giaogiaooo/AED-Rescue-Vehicle-system/fall/train/val_batch2_pred.jpg

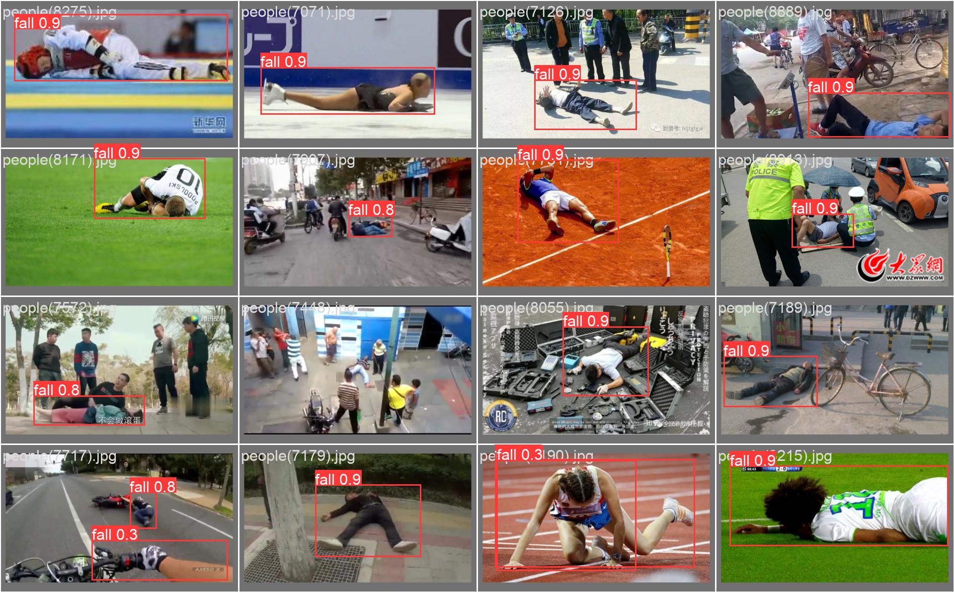
fall/train/val_batch2_pred.jpg
