giaogiaooo/AED-Rescue-Vehicle-system/fall/train/train_batch1.jpg

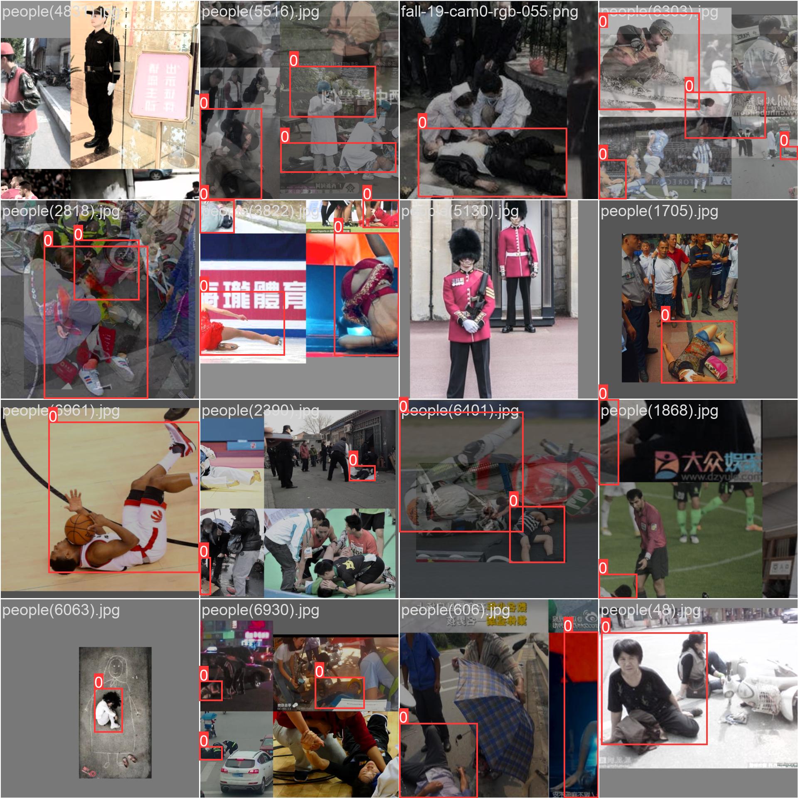
fall/train/train_batch1.jpg
