giaogiaooo/AED-Rescue-Vehicle-system/README.md

# AED Rescue Vehicle System

Intelligent AED (Automated External Defibrillator) rescue vehicle system — an integrated solution for rapid emergency cardiac arrest response.
