giaogiaooo/AED-Rescue-Vehicle-system/report/智能AED救援车系统.pdf

## 智能 AED 救援车系统

摘要

针对公共场所心脏骤停患者黄金救援时间短、传统人工取送自动体外除颤器

（AED）效率较低的问题，我们团队设计了基于 ROS2 的智能 AED 救援车系统。

该系统由主导航、目标检测、跌倒识别、语音交互、远程控制及自动返航等功能

于一体，能够在接收到救援任务后快速规划最优路径，自主避障并将 AED 运输

至目标位置，为现场急救争取宝贵时间。

本系统以 ELF2 开发板为核心，结合二维激光雷达，实现环境建模、定位导

航及障碍物检测；利用深度学习目标检测算法识别人体状态，对疑似跌倒人员进

行智能判断；在导航过程中，通过语音播报提醒周围人员避让，并引导现场人员

及时取用 AED 实施救援。到达目标点后，小车自动停止报警并等待救援完成，

在规定时间内可执行返航任务，提高设备利用率和连续工作能力。

实验结果表明，该 AED 救援小车能够在复杂室内环境中稳定完成自主导航、

动态避障、目标识别和 AED 配送任务，具有较高的导航精度、运行稳定性和实

时响应能力。该系统能够有效缩短 AED 送达时间，降低人工配送成本，为智慧

医疗、智慧校园、医院、商场及大型公共场所的应急救援提供了一种智能化、自

动化的解决方案，具有良好的应用价值和推广前景。

关键词：AED；智能救援小车；ROS2；自主导航；跌倒检测；激光雷达；目标

识别

第一部分作品概述

2.1 功能与特性

智能 AED 急救小车旨在解决公共场所突发心搏骤停时“黄金四分钟”

内的 AED 快速投递问题，化被动的“人找设备”为主动的“设备找人”。其

核心功能包括：

跌倒精确识别：通过 rknn 模型接入远程摄像头的视频，实现对患者跌倒

的快速识别，同时为了准确性，调高置信度，加入连续十帧触发机制，避免

误识别。

自主导航与动态避障：结合 Nav2 导航和 AMCL 定位，小车能在复杂、

人流密集的室内外环境中自主规划最优路径，并实现对行人及障碍物的实时

动态避让。

实时语音交互：设备内置扬声器，可实现语音播报和警报功能，汇报当

前执行情况，并在行程中鸣笛提醒周围行人注意避让。

本小车具备响应速度快、部署灵活、人机交互界面友好等特性，极大提

升了公共空间的急救效率。

2.2 应用领域

智能 AED 救援小车主要应用于面积广阔、人流密集且突发心血管疾病

风险较高的公共场所。具体包括：

大型交通枢纽：如地铁站（例如徐州地铁网内各站）、高铁站、机场航站

楼，解决站内面积庞大、人工寻找固定 AED 耗时过长的问题。

高校校园与体育场馆：针对学生进行高强度体测（如 3km 长跑或 400m

冲刺）、大型体育赛事及日常操场锻炼时突发心脏骤停事件，提供快速的赛道

旁医疗响应。

大型商超与展览中心：在内部结构复杂的商业环境中，小车能够穿梭于

人群和货架之间，精准将设备送达求救者手中。

智慧社区与工业园区：作为智慧安防与医疗基础设施的一部分，与园区

的监控系统联动，为老年人和工作者提供全天候的生命保障。

2.3 主要技术特点

本系统采用 ROS 机器人操作系统作为软件框架，实现模块化设计与多

节点协同运行。

（1）基于激光雷达 SLAM 技术完成环境建图与 AMCL 定位，实现高精

度自主导航；

（2）采用全局路径规划与局部避障算法，能够在复杂环境下安全运行；

（3）结合深度学习目标检测技术，实现跌倒人员识别与救援目标确认；

（4）支持远程监控与任务调度，可实时查看小车运行状态；

（5）具备自动返航与待机功能，提高设备利用率和系统可靠性；

（6）采用模块化硬件架构，便于后续功能扩展和维护升级。

2.4 主要性能指标

2.5 主要创新点

（1）将AED配送与自主移动机器人技术相结合，实现急救设备智能化配送。

（2）融合激光雷达导航与视觉跌倒检测技术，实现“发现—运输—送达”一

体化救援流程。

（3）设计智能语音引导机制，提高现场群众参与急救的效率。

（4）具备自动返航与循环工作能力，提升公共场所 AED 设备利用率。

（5）采用 ROS 模块化架构，便于后续功能扩展和智慧医疗系统接入。

指标项目 | 性能参数
导航方式 | 激光雷达自主导航
定位精度 | ≤10cm
最大运行速度 | 0.8~1.2m/s
避障距离 | ≥0.3m
跌倒检测准确率 | ≥90%
自动返航成功率 | ≥95%

2.6 设计流程

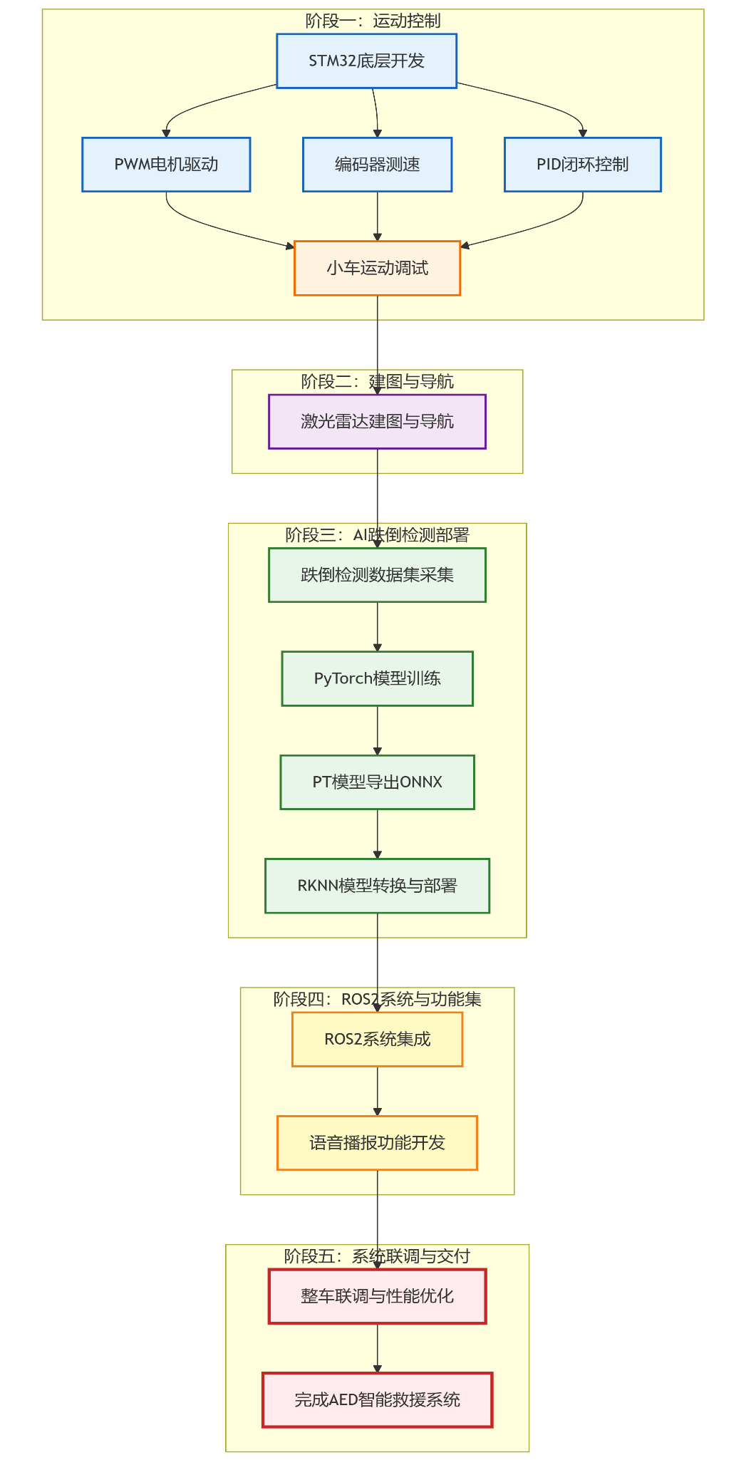
[picture p3: figure]

第二部分系统组成及功能说明

2.1 整体介绍

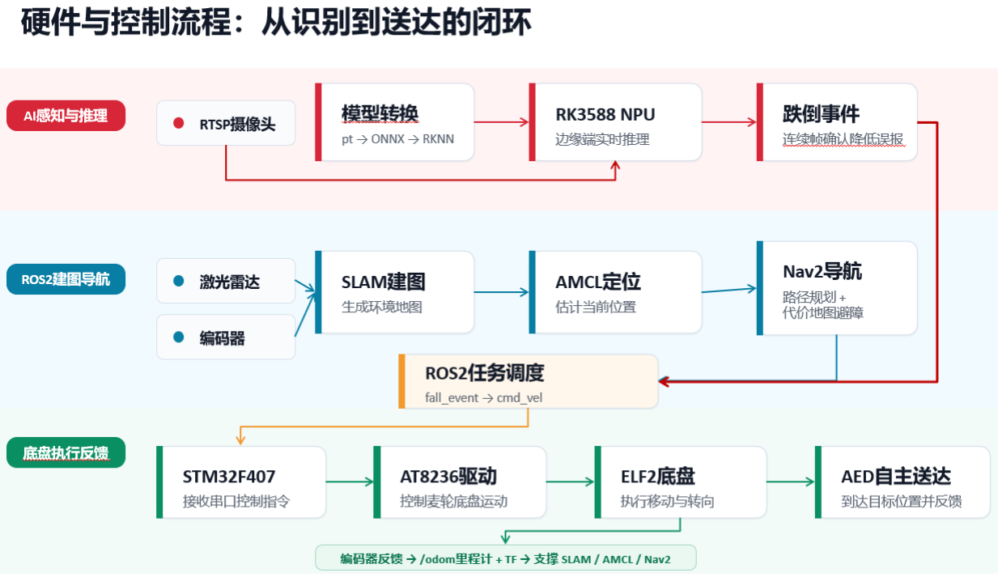
[picture p4: figure]

2.2 硬件系统介绍

2.2.1 硬件整体介绍

本系统采用"上位机智能决策+下位机运动控制"的分层硬件架构，由

ELF2 边缘计算平台、STM32 运动控制器、激光雷达、驱动模块、动力系统

及通信模块组成。

ELF2 作为系统上位机，负责运行 Ubuntu 操作系统及 ROS2 框架，完成

地图构建、自主导航、路径规划、跌倒检测模型推理、任务调度及语音播报

等高层功能。视觉算法采用 RKNN 部署于 ELF2 内置 NPU，实现跌倒检测模

型的边缘端实时推理。

STM32 作为底层运动控制核心，主要负责底盘运动控制及外设管理，包

括 PWM 输出、电机速度闭环控制、编码器数据采集、超声波测距及各类 IO

控制。STM32 根据 ELF2 发送的速度指令完成左右轮电机控制，并实时反馈

编码器信息，为自主导航提供稳定可靠的运动基础。

电机驱动部分采用 AT8236 双路直流电机驱动模块，可提供较大的输出

电流，支持 PWM 调速及电机正反转控制。STM32 输出 PWM 及方向控制信

号至 AT8236，驱动两台 520 减速直流电机完成差速运动，实现前进、后退、

转向及原地旋转等动作。

环境感知部分采用 LD06 二维激光雷达，实现周围环境扫描与障碍物检

测。LD06 通过串口与 ELF2 通信，配合 ROS2 完成 SLAM 建图、AMCL 定

位及 Nav2 自主导航，为车辆提供可靠的环境感知能力。

ELF2 与 STM32 之间采用 TTL 转 USB 通信模块进行串口数据交互。

STM32 通过 USART 发送底盘状态、编码器速度等信息，ELF2 接收导航算

法计算得到的速度控制指令，并将其发送至 STM32 执行，实现上下位机之

间稳定、高效的数据通信。

系统动力部分采用四台 520 减速直流电机作为驱动机构，配合编码器实

现闭环速度控制，提高车辆运动精度及导航稳定性。整车采用大容量锂电池

集中供电，并通过降压模块为激光雷达提供稳定电源，保证系统长时间稳定

运行。

2.2.2 机械设计介绍（如果有的话，从总体到局部，逐级给出各组件的具体设

计图，可以是 CAD 文件截图或者手绘图片）；

车壳采用 3D 打印的方式，分开打印车壳和 AED 底座、AED 模型，再

将三者组装到一起。其中，车壳上方预留了雷达的孔位，车后侧预留了和 AED

底座的螺丝连接口，侧面增加了散热口。AED 模型通过磁吸方式与 AED 底

座连接。摄像头外壳也采用了 3D 打印，起到一个保护且更加美观的效果。

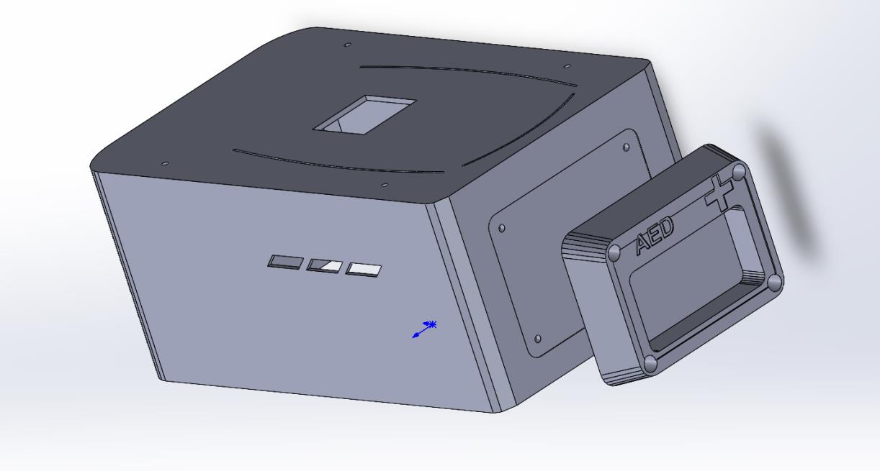
[picture p5: figure]

图 2.2.2.1 车体设计

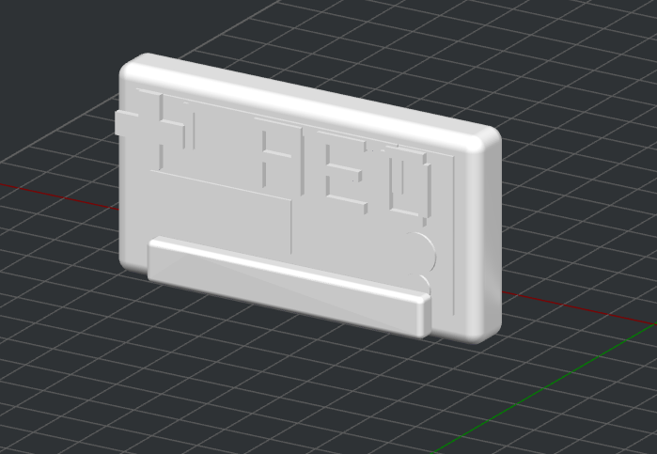
[picture p6: figure]

图 2.2.2.2AED 模型设计

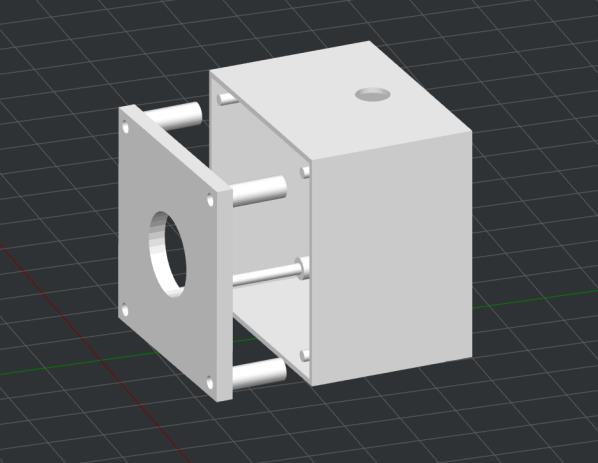
[picture p7: figure]

图 2.2.2.3 摄像头外壳设计

2.2.3 电路各模块介绍（从总体到局部，逐级给出各模块的具体设计图，并标

记出关键的输入、输出信号线，可以是电路图、SCH 原理图、PCB 版图等截图）；

1.总体连接关系

整车电路可以按“上位机计算、底层控制、感知供电、动力执行”四层理解。ELF2

负责接收 LD06 雷达数据并运行导航/上位机逻辑；STM32F407ZGT6 通过 TTL 转

USB 接收 ELF2 指令；AT8236 根据 STM32F407ZGT6 的 A/B 路控制信号驱动 520 马

达，同时将执行状态、故障或采样信息回传给 STM32F407ZGT6。

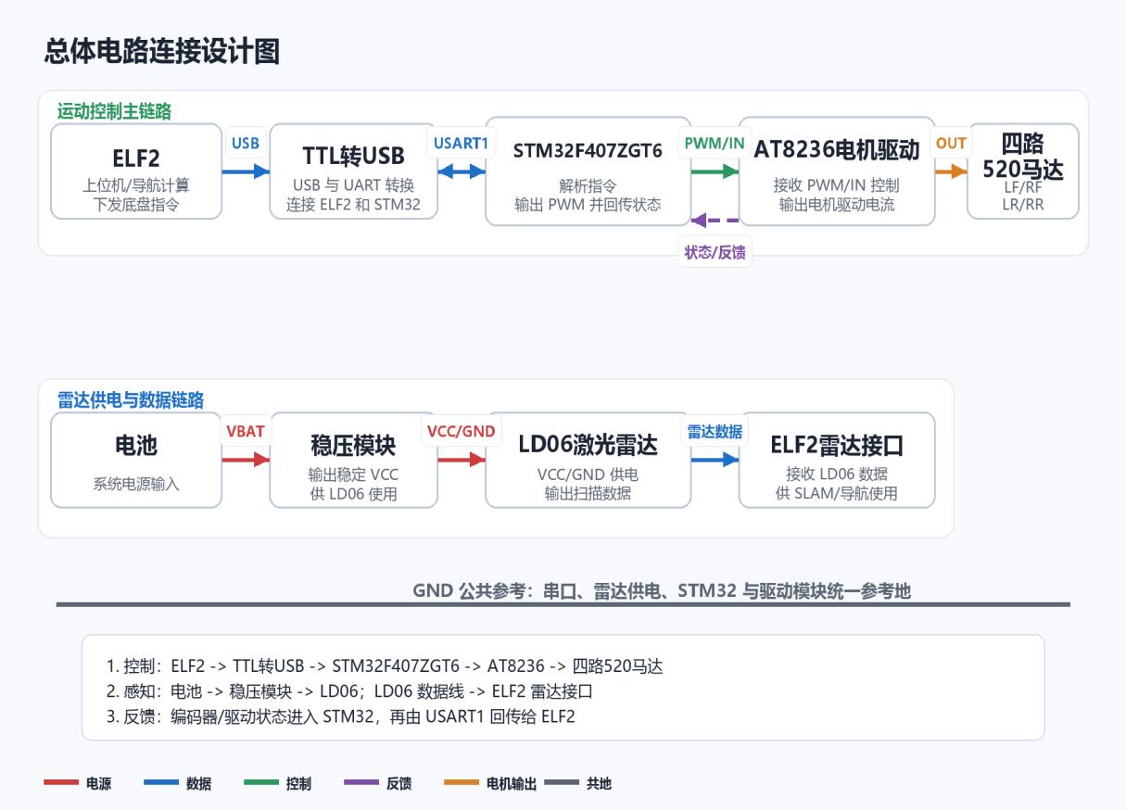
[picture p8: figure]

图 2.2.3.1 总体电路连接设计图：电源、数据、控制、反馈与电机输出主线

模块 | 关键输入 | 关键输出 | 主要作用
ELF2 | LD06 雷达数据； STM32F407ZGT6 回传 状态 | 经 TTL 转 USB 下发运 动/控制指令 | 作为上位机和导航计算 平台，完成感知数据接 收、路径/任务逻辑和底 盘指令下发。
TTL 转 USB | ELF2USB； STM32F407ZGT6UART TX/RX/GND | USB 与 TTL 串口数据 互转 | 把 ELF2 的 USB 通信转换 为 STM32F407ZGT6 可用 的 UART 串口通信。
STM32F407 ZGT6 | TTL 串口指令；四路 编码器反馈 | TIM3/TIM4 共 8 路 PWM；USART1 状态回 传 | 作为底层控制器，解析 上 位 机 指 令 ， 执 行 20msPID 闭环并控制四 个电机。
AT8236 | STM32F407ZGT6PWM 控制信号；电机电 | 四个520马达功率输 出 | 完成电机功率驱动，将 低功率 PWM 控制信号转

| 源 VM/GND | | 换为马达驱动电流。
LD06 | 稳压模块 VCC/GND | 雷达扫描数据线至 ELF2 | 提供激光雷达扫描数 据，供 ELF2 进行定位、 建图或导航。
稳压模块/ 电池 | 电池输入 | 稳定电源给 LD06 等 负载 | 提供稳定供电，降低电 池电压波动对雷达工作 的影响。

(1).ELF2 与 STM32F407ZGT6 串口通信

ELF2 与 STM32F407ZGT6 之间使用 TTL 转 USB 模块建立串口链路。STM32F407ZGT6

属于 STM32F407 系列，具备多路 USART/UART、定时器 PWM 和丰富 GPIO，适合承

担底盘控制、驱动输出和状态采集任务。

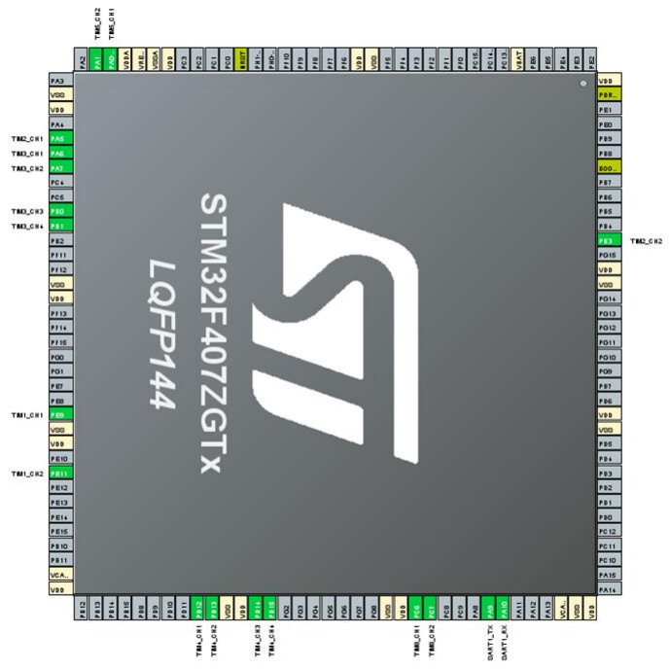
[picture p9: figure]

图 2.2.3.(1).1STM32F407ZGT6 使用引脚

电机 | STM32F407ZGT6 引脚/复用 | 连接对象 | 具体功能
左前电机 | PD12/TIM4_CH1； PD13/TIM4_CH2 | AT8236 模块 1AIN1/AIN2 | 正转 PWM 输出 反转 PWM 输出
左后电机 | PD14/TIM4_CH3； PD15/TIM4_CH4 | AT8236 模块 1BIN1/BIN2 | 正转 PWM 输出 反转 PWM 输出
右前电机 | PA6/TIM3_CH1； PA7/TIM3_CH2 | AT8236 模块 2AIN1/AIN2 | 反转 PWM 输出 正转 PWM 输出
右后电机 | PB0/TIM3_CH3； PB1/TIM3_CH4 | AT8236 模块 2BIN1/BIN2 | 反转 PWM 输出 正转 PWM 输出

表（1）.1 PWM 输出引脚分配

电机 | STM32F407ZGT6 引脚/复用 | 连接对象 | 功能
左前轮（LF） | TIM1 | CH1 | PE9
左前轮（LF） | TIM1 | CH2 | PE11
右前轮（RF） | TIM2 | CH1 | PA5
右前轮（RF） | TIM2 | CH2 | PB3
左后轮（LR） | TIM5 | CH1 | PA0
左后轮（LR） | TIM5 | CH2 | PA1
右后轮（RR） | TIM8 | CH1 | PC6
右后轮（RR） | TIM8 | CH2 | PC7

表（1）.2 编码器接口分配

外设 | GPIO | 功能
USART1 | PA9 | TX（串口发送）
USART1 | PA10 | RX（串口接收）

表（1）.3 USART1 串口接口分配

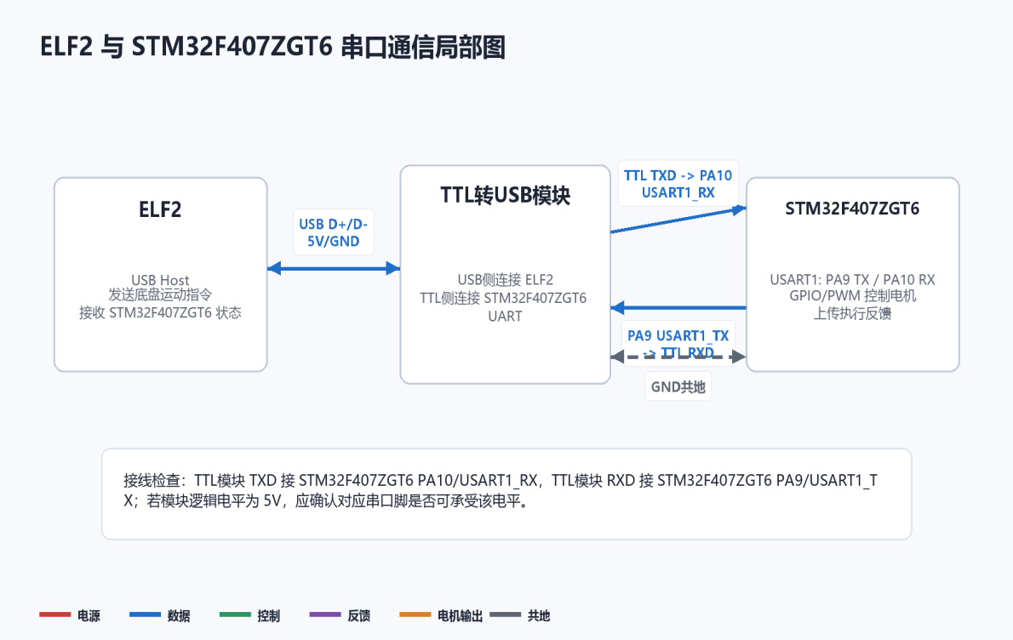
[picture p10: figure]

图 2.2.3.1(1).2 ELF2、TTL 转 USB、STM32F407ZGT6 通信局部设计图

信号线 | 方向 | 连接关系 | 设计要点
USB | ELF2->TTL 转 USB | ELF2USB 口连接 TTL 转 USB 模块 USB 侧 | 用于把上位机通信接 入串口转换模块。
TXD/RXD | 双向 | TTL （ TXD ） 连接 STM32F407ZGT6(RXD)PA10 ；STM32F407ZGT6（TXD）连 接 TTL(RXD) | 串口收发需要交叉连 接，并保证波特率、数 据位、校验位一致。
GND | 公共参考 | TTL 转 USBGND 与 STM32F407ZGT6GND 相连 | 串口通信必须共地，否 则电平参考不一致会 导致通信异常。

表（1）.4 TTL-USB 连接关系

主文件中 USART1 配置为 115200baud、8 数据位、1 停止位、无校验。

STM32F407ZGT6 每 20ms 执行一次闭环控制，并以 20ms 周期向 ELF2 上传四路编

码器增量。

通信方向 | 帧格式 | 载荷含义 | 用途
ELF2->STM32F407 ZGT6 | AA55+vx(2B)+vy(2B)+w(2B)+S UM+0D | 目标前后速度、横向 速度、角速度 | 接收 ROS2/ 上位机下发 的底盘运动 指令，并刷 新 500ms 看 门狗。
STM32F407ZGT6-> ELF2 | AA66+LF/RF/LR/RR 编码器增 量各 2B+SUM+0D | 四个 520 马达的编码 器原始增量 | 用于上位机 获得底盘执 行反馈，支 持里程计、 速度闭环或 状态监控。

表（1）.5 ELF2-STM 交互信息

(2).STM32F407ZGT6、AT8236 与 520 马达模块

STM32F407ZGT6 作为底盘控制核心，向 AT8236 输出电机控制信号；AT8236

负责功率放大并驱动 520 马达。主文件显示底盘为四轮闭环结构：TIM4 的 4 路

PWM 控制左前/左后，TIM3 的 4 路 PWM 控制右前/右后；每个 520 马达占用一对

AT8236 输入脚。

AT8236芯片资料显示其为单通道直流有刷H桥驱动，核心控制脚为IN1/IN2，

功率输出为 OUT1/OUT2；若使用双路电机驱动模块，则四轮底盘通常需要两块双

路模块或等效四路驱动。主文件中的闭环反馈主要来自四路编码器：TIM1、TIM2、

TIM5、TIM8 分别读取 LF、RF、LR、RR 的编码器增量，并通过 USART1 回传给 ELF2。

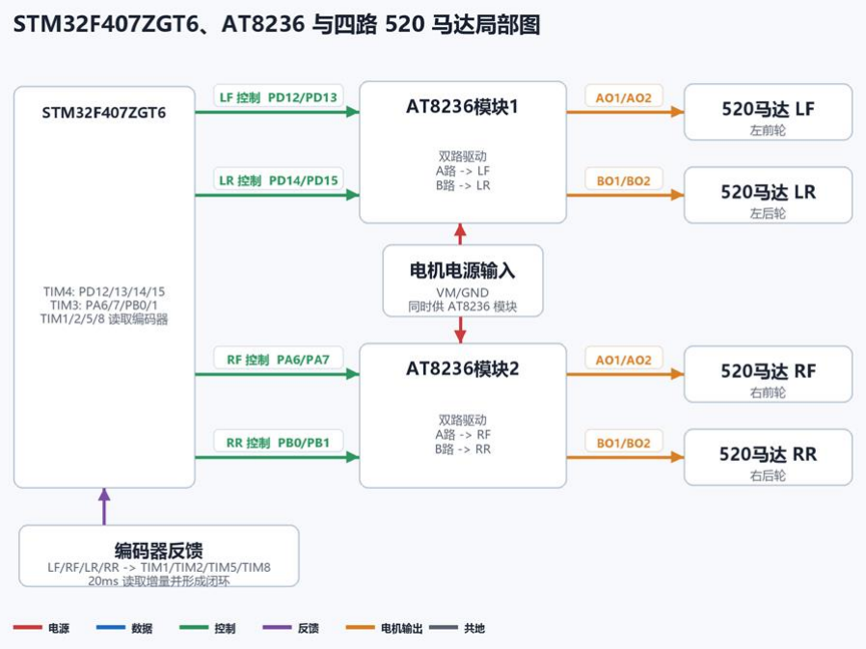
[picture p11: figure]

图 2.2.3.1(2).1 STM32F407ZGT6、AT8236 电机驱动与 520 马达局部设计图

定时器 | 功能
TIM1 | 左前轮编码器
TIM2 | 右前轮编码器
TIM3 | 右侧电机 PWM 输出
TIM4 | 左侧电机 PWM 输出
TIM5 | 左后轮编码器
TIM8 | 右后轮编码器

表（2）.1 STM32 定时器资源分配

外设 | GPIO | 功能
TIM5_CH1 | PA0 | 左后轮编码器 A 相
TIM5_CH2 | PA1 | 左后轮编码器 B 相
TIM2_CH1 | PA5 | 右前轮编码器 A 相

TIM3_CH1 | PA6 | 右前轮 PWM 反转
TIM3_CH2 | PA7 | 右前轮 PWM 正转
USART1_TX | PA9 | 串口发送
USART1_RX | PA10 | 串口接收
TIM3_CH3 | PB0 | 右后轮 PWM 反转
TIM3_CH4 | PB1 | 右后轮 PWM 正转
TIM2_CH2 | PB3 | 右前轮编码器 B 相
TIM8_CH1 | PC6 | 右后轮编码器 A 相
TIM8_CH2 | PC7 | 右后轮编码器 B 相
TIM4_CH1 | PD12 | 左前轮 PWM 正转
TIM4_CH2 | PD13 | 左前轮 PWM 反转
TIM4_CH3 | PD14 | 左后轮 PWM 正转
TIM4_CH4 | PD15 | 左后轮 PWM 反转
TIM1_CH1 | PE9 | 左前轮编码器 A 相
TIM1_CH2 | PE11 | 左前轮编码器 B 相

表（2）.2 STM32 GPIO 资源汇总

(3).LD06 激光雷达供电与数据模块

LD06 的供电链路由电池先进入稳压模块，再由稳压模块给雷达提供稳定电源；

雷达数据线直接连接 ELF2，用于给上位机提供扫描数据。电源线和数据线在图

纸上应分开标注，避免把供电链路和数据链路混在一起。

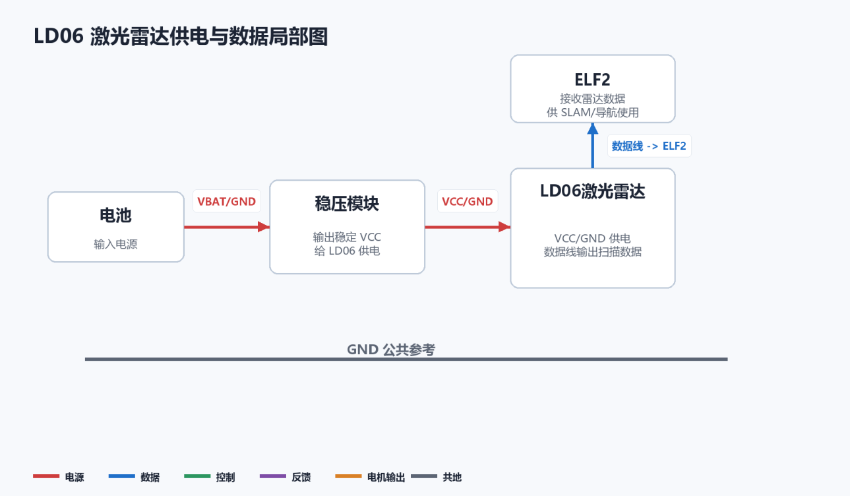
[picture p12: figure]

图 2.2.3.1(3).1 激光雷达供电与数据局部设计图

链路 | 输入端 | 输出端 | 关键检查点
雷达供电 | 电池 | 稳压模块输入 | 确认输入电压范围满足稳压模 块要求。
稳定输出 | 稳压模块 | LD06VCC/GND | 输出电压和电流能力应满足 LD06 工作要求。
雷达数据 | LD06 数据线 | ELF2 雷达数据接口 | 标注数据方向，并确认接口协 议、波特率或驱动配置一致。
公共地 | 稳压模块 GND | LD06/ELF2/STM32F407 ZGT6 系统地 | 建议最终共地，减少数据线参 考电平不一致问题。

2.主要电路原理图

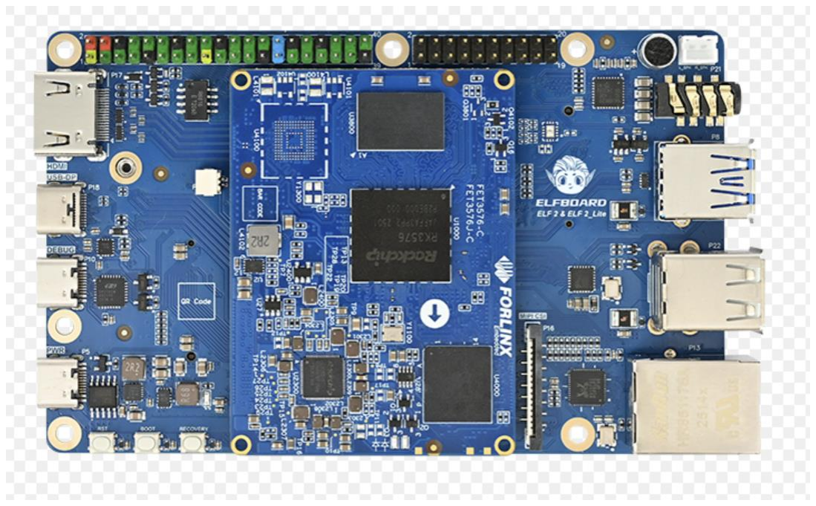
[picture p13: figure]
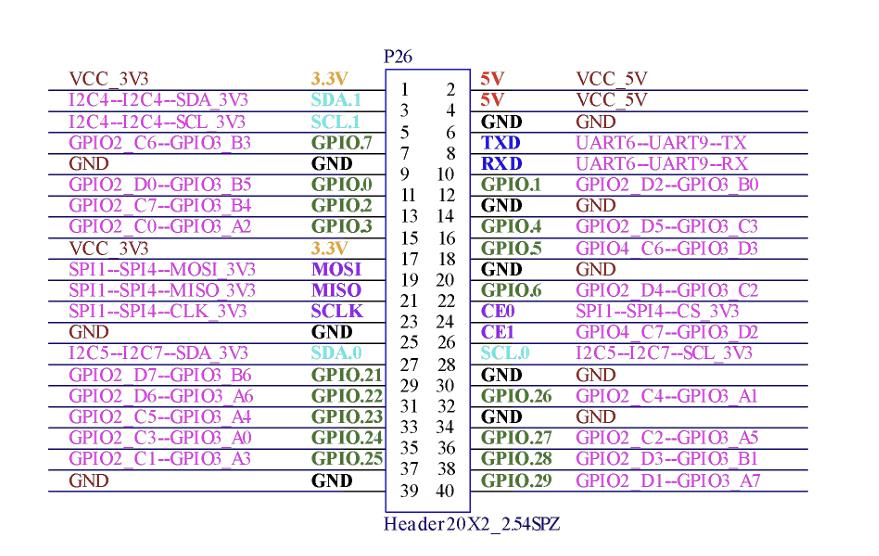
[picture p14: figure]

图 2.2.3.2.1 ELF2 开发板及 40pin 排针原理图

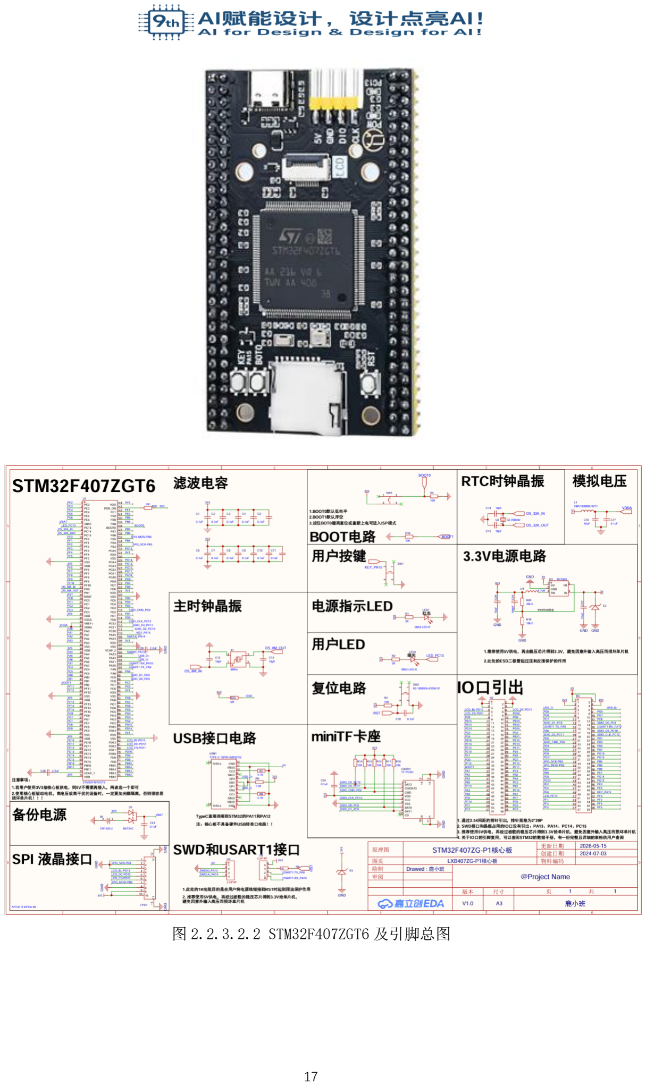
[picture p15: page 17]

图 2.2.3.2.2 STM32F407ZGT6 及引脚总图

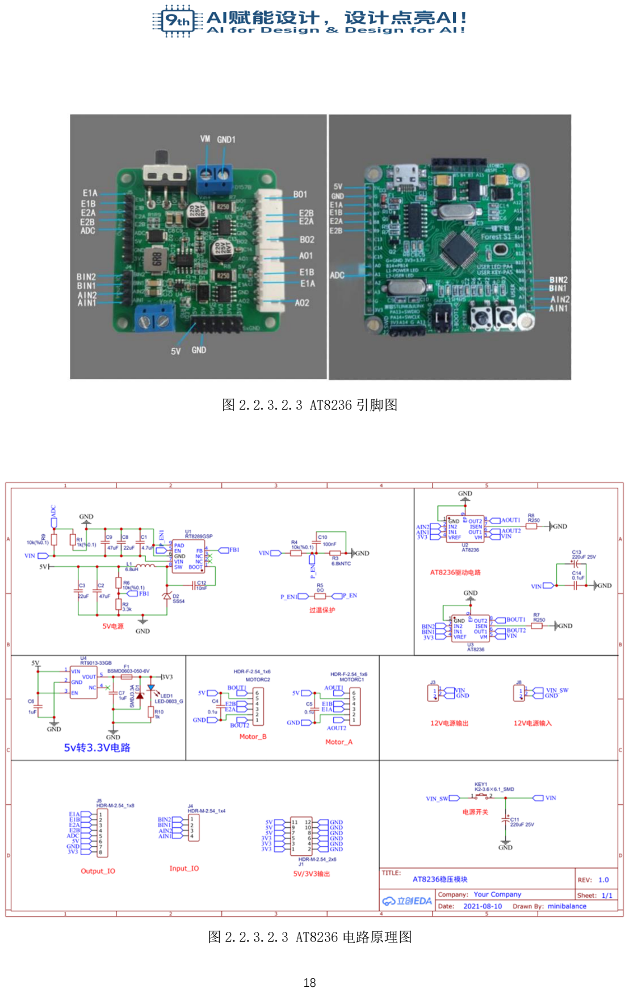
[picture p16: page 18]

图 2.2.3.2.3 AT8236 引脚图

图 2.2.3.2.3 AT8236 电路原理图

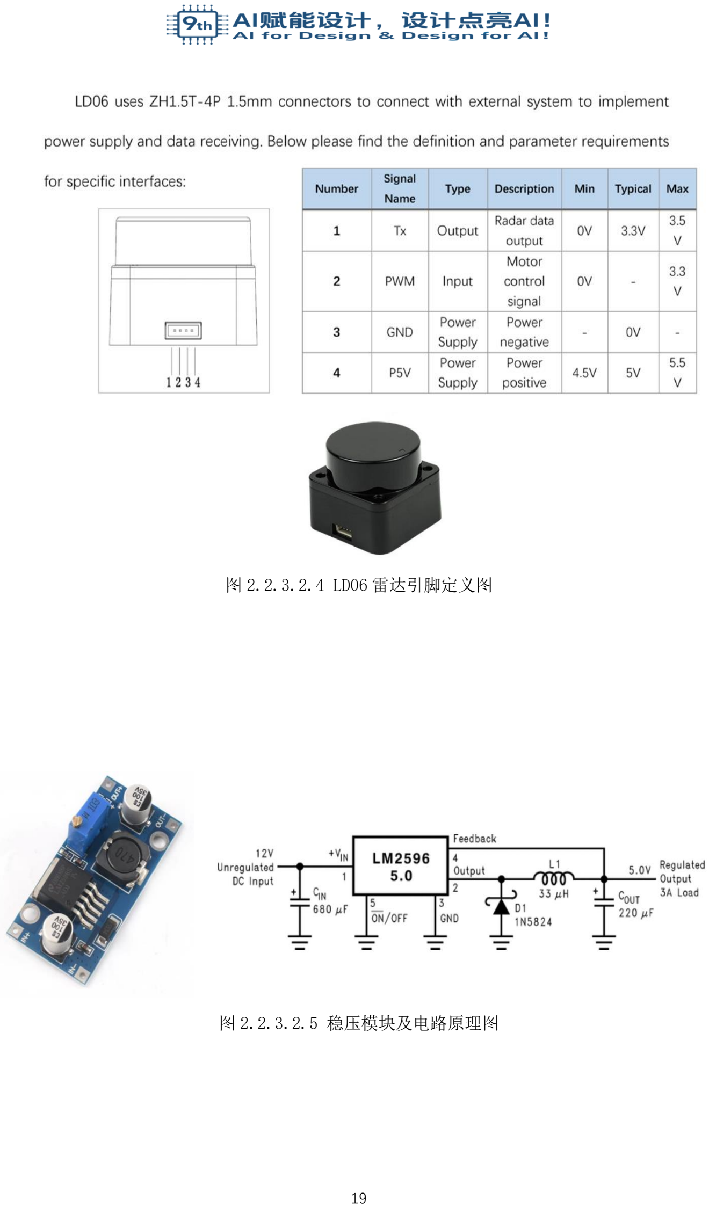
[picture p17: page 19]

图 2.2.3.2.4 LD06 雷达引脚定义图

图 2.2.3.2.5 稳压模块及电路原理图

2.3 软件系统介绍

2.3.1 软件整体介绍（含 PC 端或云端，结合关键图片）；

一、软件概述

智能 AED 救援车监控平台是一款用于远程监控搭载 AED（自动体外除颤器）救援

机器人运行状态的桌面/移动端软件。系统通过 WebSocket 连接 ROS2 机器人系统，提

供实时地图渲染、视频监控、状态遥测与智能报警等一体化监控功能。

二、技术栈

类别 | 技术
编程语言 | Python3
桌面 GUI | PyQt5
机器人通信 | roslibpy（通过 rosbridge_server 的 WebSocket 协议连接 ROS2）
计算机视觉 | OpenCV+YOLOv8
AI 推理 | YOLOv8 跌倒检测模型（fall.rknn）
数据持久化 | SQLite（报警记录存储）
数值计算 | NumPy
打包工具 | PyInstaller（打包为 EXE）

三、项目结构

AED_UI/
├──main.py#程序入口
├──ui/
│├──main_window.py#主窗口（三栏布局+报警系统） │└──alarm_window.py#历史报警弹窗（分页查询）
├──widgets/
│├──map_widget.py#地图渲染（OccupancyGrid+LaserScan+Nav2Path） │└──camera_widget.py#RTSP 摄像头+YOLO 跌倒检测
├──ros/
│└──ros_client.py#ROS2WebSocket 通信线程 ├──database/
│└──db.py#SQLite 数据库管理
├──kivy_build/#Android/Kivy 版本 │├──main.py#Kivy 主程序
│├──aed.kv#Kivy 布局文件
│├──ros_client.py#Kivy 版 ROS 客户端 │└──buildozer.spec#Buildozer 打包配置 ├──best.onnx/best.pt#YOLOv8 跌倒检测模型 ├──logo.jpg/logo.ico#应用图标
└──打包为 EXE.bat#PyInstaller 打包脚本

四、界面布局

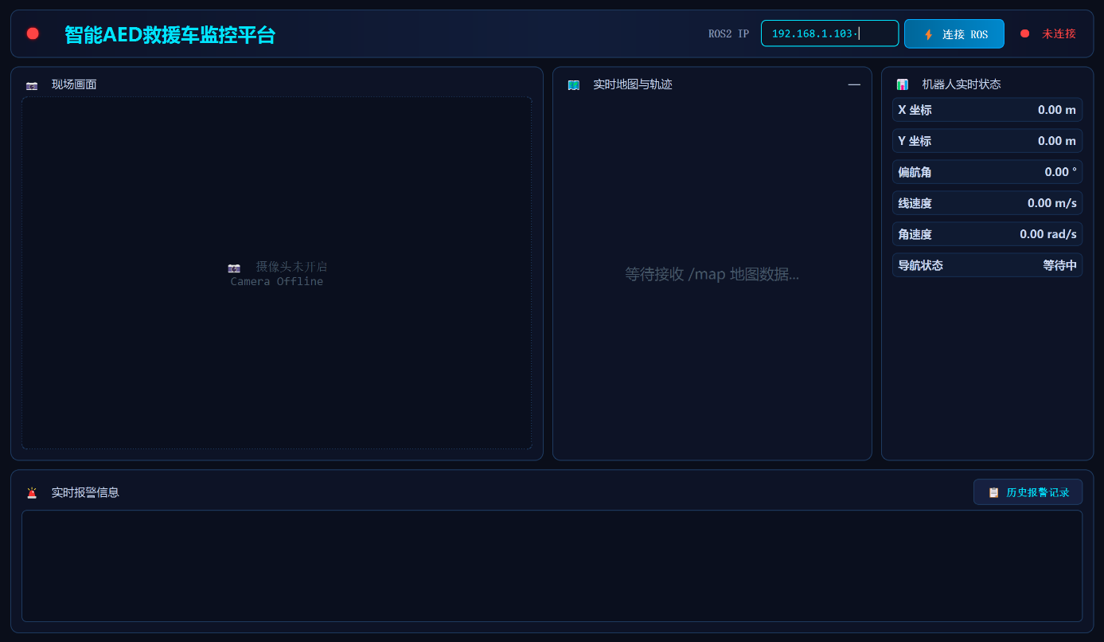
[picture p18: figure]

五、使用流程

1.启动程序→自动尝试连接 RTSP 摄像头

2.输入机器人 IP 地址→点击「连接 ROS」

3.连接成功后自动接收地图、位姿、激光、路径等数据

4.实时监控机器人运行状态和现场画面

5.发生跌倒/导航失败等紧急事件→界面自动切换红色警报模式

6.可随时查看历史报警记录

2.3.2 软件各模块介绍（根据总体框图，给出各模块的具体设计说明。从顶层

到底层逐次给出各函数的流程图及其关键输入、输出变量）；

1.ROS2 机器人通信（ros/ros_client.py）

通过 roslibpy 以 WebSocket 方式连接机器丞 rosbridge_server（默认端口 9090）

订阅 8 个 ROSTopic：
/amcl_pose—AMCL 全局定位（机器人位姿）
/odom—里程计（速度信息）
/scan—激光雷达点云
/map—栅格占据地图

/plan—Nav2 全局规划路径

/navigate_to_pose/_action/status—导航状态反馈

/fall_detection//aed_fall_detection—跌倒检测（双 Topic 兜底）

/fall_event—跌倒报警开关

支持发布导航目标到/goal_pose

2.实时地图渲染（widgets/map_widget.py）

基于 PyQtQPainter 原生绘制，实现 ROS 世界坐标→Qt 像素坐标的完整坐标变 换
渲染内容：
栅格地图底图：解析 OccupancyGrid，颜色映射（未知=灰色、空闲=白色、障 碍=黑色、概率值=灰度渐变）
激光雷达点云：红色散点，实时反映环境障碍物
Nav2 全局路径：蓝色虚线，显示导航规划路线
机器人图标：蓝色圆形+黄色方向箭头
图例：右上角标注
交互方式：滚轮缩放+鼠标拖拽平移，首次加载自动适配视图

3.摄像头与 AI 跌倒检测（widgets/camera_widget.py）

支持 RTSP 网络摄像头（默认地址 rtsp://admin:@192.168.1.86）或 USB 摄像头 集成 YOLOv8 跌倒检测模型，支持 ONNX 和 PT 两种格式
检测逻辑：
连续 8 帧检测到跌倒→触发红色报警
报警冷却时间 5 秒（避免重复报警）
几何规则过滤（宽高比、最小尺寸等）
画面实时标注检测框和跌倒计数

4.机器人状态面板

右侧面板实时显示 6 项关键遥测数据：
指标 | 来源
X/Y 坐标 | AMCL 全局定位
偏航角 | AMCL
线速度 | 里程计
角速度 | 里程计

导航状态 | Nav2Action 反馈

导航状态带颜色区分：执行中=青色、成功=绿色、失败=红色。

5.多级报警系统

报警等级

●红色报警（严重）
●橙色警告（中等）
●黄色提醒（轻度）

触发源

YOLO 跌倒检测→红色报警
导航失败（ABORTED）→红色报警
激光避障（已注释禁用，可重新启用）

视觉反馈

触发红色报警时，整个界面切换为红色警报主题（深红背景、红色边框、红色 标题），顶部显示警报横幅
自动恢复：红色报警 10 秒无新触发后自动恢复正常界面

历史记录

SQLite 存储+分页查询弹窗（每页 15 条）

第三部分完成情况及性能参数

阐述最终实现的成果（图文结合，实物照片为主）

3.1 整体介绍（整个系统实物的正面、斜 45°全局性照片）

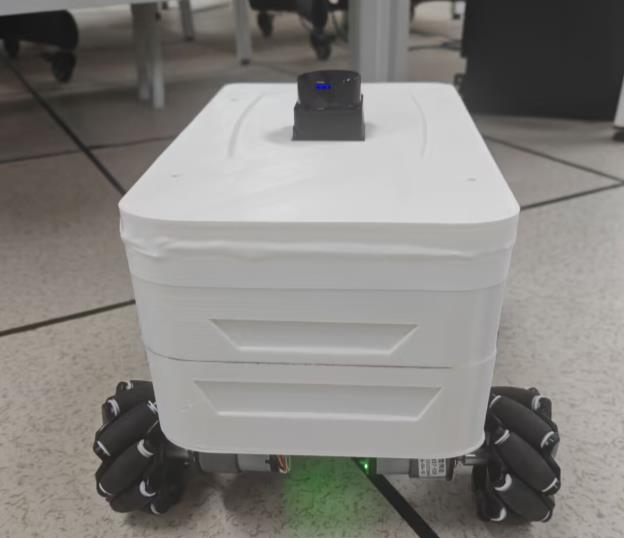
[picture p19: figure]

图 3.2.1.2 正面照片

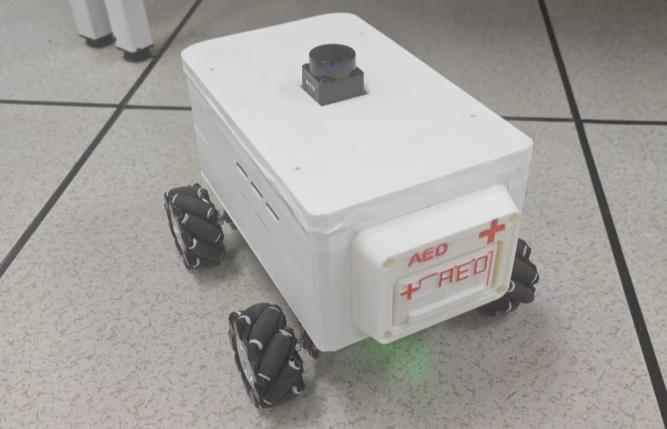
[picture p20: figure]

图 3.2.1.2 斜面照片

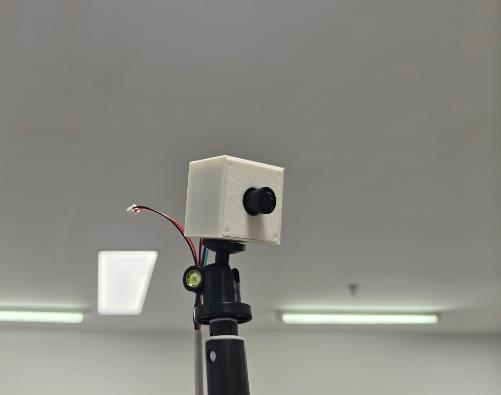
[picture p21: figure]

图 3.2.1.3 远程摄像头照片

3.2 工程成果（分硬件实物、软件界面等设计结果）

3.2.1 机械成果；（实物照片）

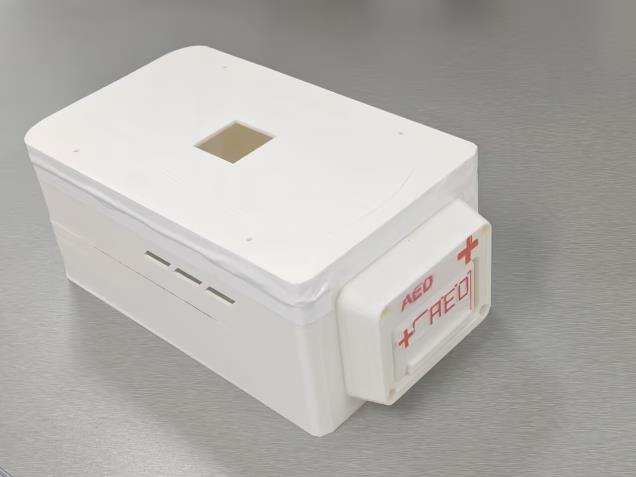
[picture p22: figure]

3.2.2 电路成果；（实物照片）

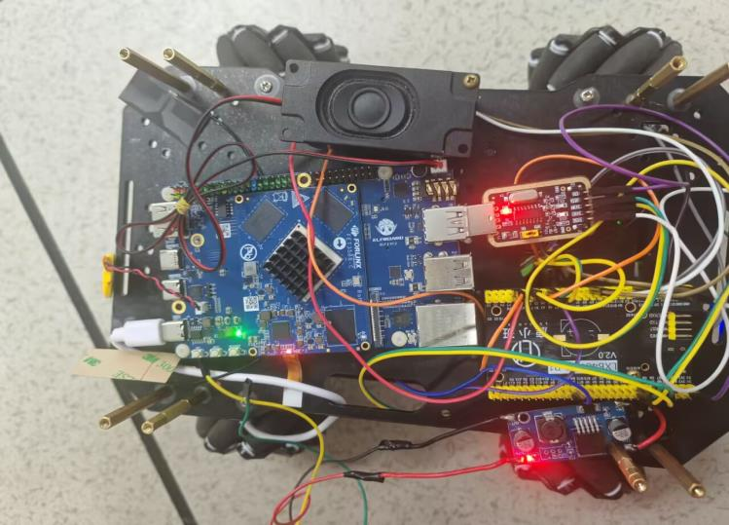
[picture p23: figure]
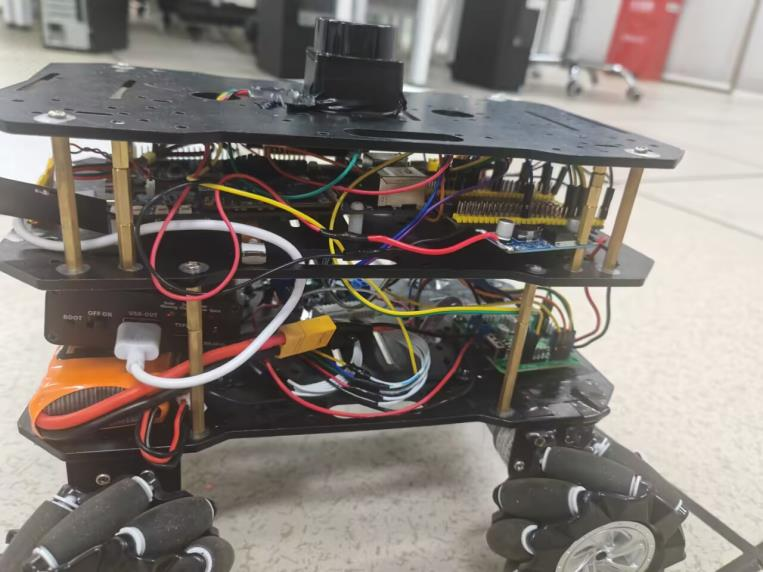
[picture p24: figure]
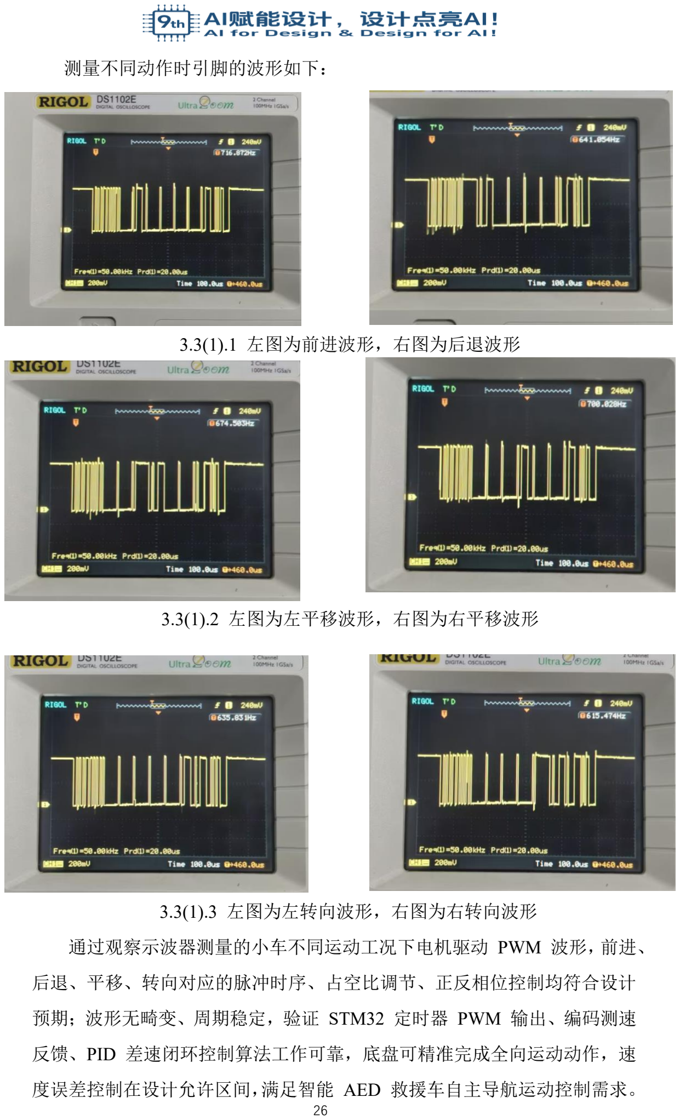
[picture p25: page 26]

测量不同动作时引脚的波形如下：

3.3(1).1 左图为前进波形，右图为后退波形

3.3(1).2 左图为左平移波形，右图为右平移波形

3.3(1).3 左图为左转向波形，右图为右转向波形

通过观察示波器测量的小车不同运动工况下电机驱动 PWM 波形，前进、

后退、平移、转向对应的脉冲时序、占空比调节、正反相位控制均符合设计

预期；波形无畸变、周期稳定，验证 STM32 定时器 PWM 输出、编码测速

反馈、PID 差速闭环控制算法工作可靠，底盘可精准完成全向运动动作，速

度误差控制在设计允许区间，满足智能 AED 救援车自主导航运动控制需求。

（2）激光雷达建图与自主导航

首先正确连接 LD06 雷达之后，测量雷达的输出波形，波形正常。

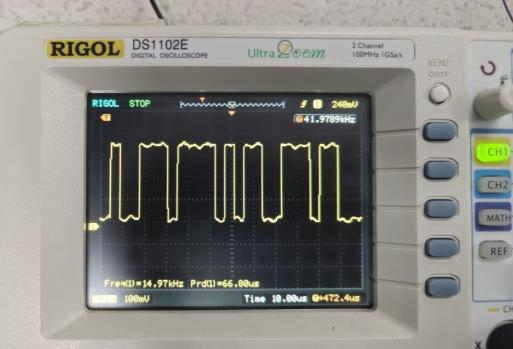
[picture p26: figure]

图 3.3.（2）1 雷达输出波形

利用 LD06 激光雷达完成环境建图，并基于 ROS2Nav2 实现自主导航。系统

能够自动规划最优路径，并在存在障碍物情况下完成动态避障。首先启动底盘与

雷达驱动，检查 ros2runtf2_toolsview_frames，确认 TF 树完整且无断裂。打开

SLAM 在 ros 的 map 节点上建图，通过编译的文件控制小车不断移动，慢慢在虚

拟机 rviz2 软件上出现地图的轮廓，跑完整后将地图保存。

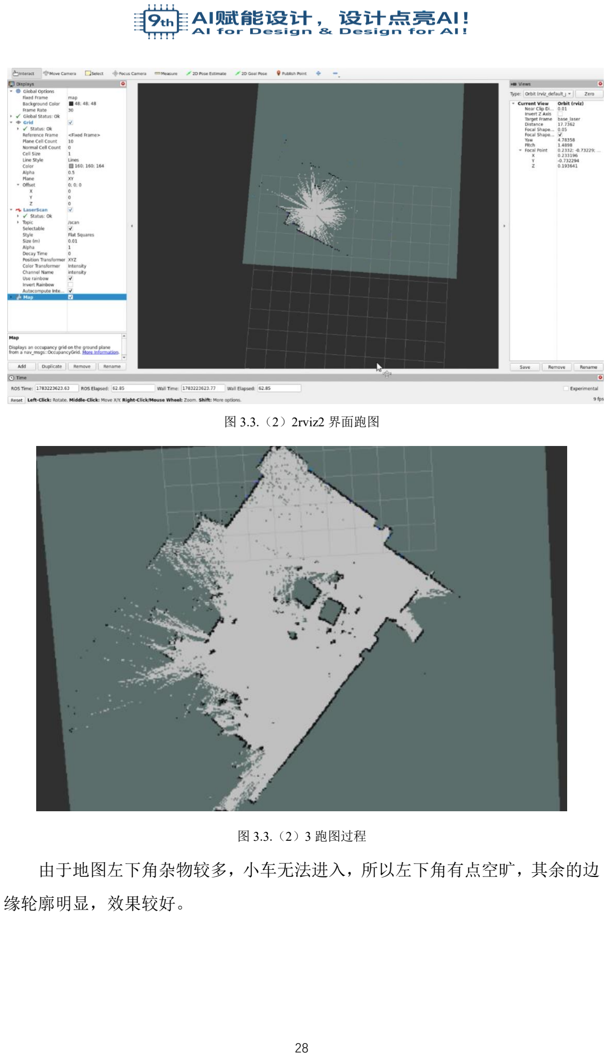
[picture p27: page 28]

图 3.3.（2）2rviz2 界面跑图

图 3.3.（2）3 跑图过程

由于地图左下角杂物较多，小车无法进入，所以左下角有点空旷，其余的边

缘轮廓明显，效果较好。

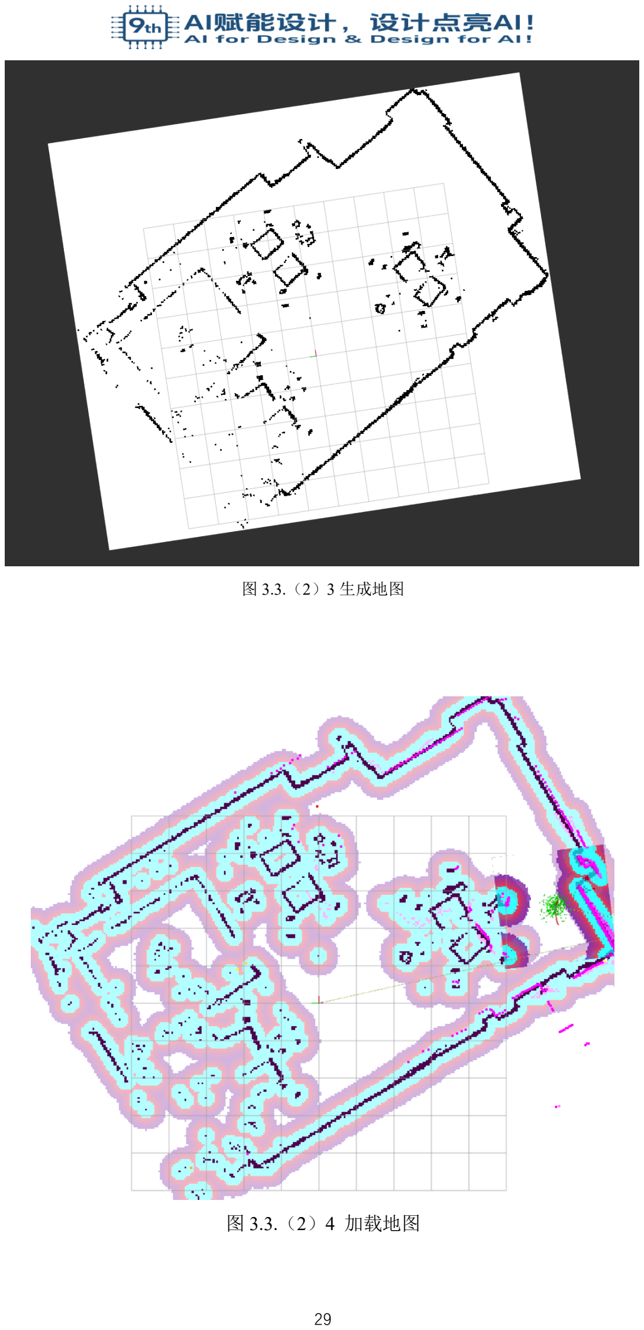
[picture p28: page 29]

图 3.3.（2）3 生成地图

图 3.3.（2）4 加载地图

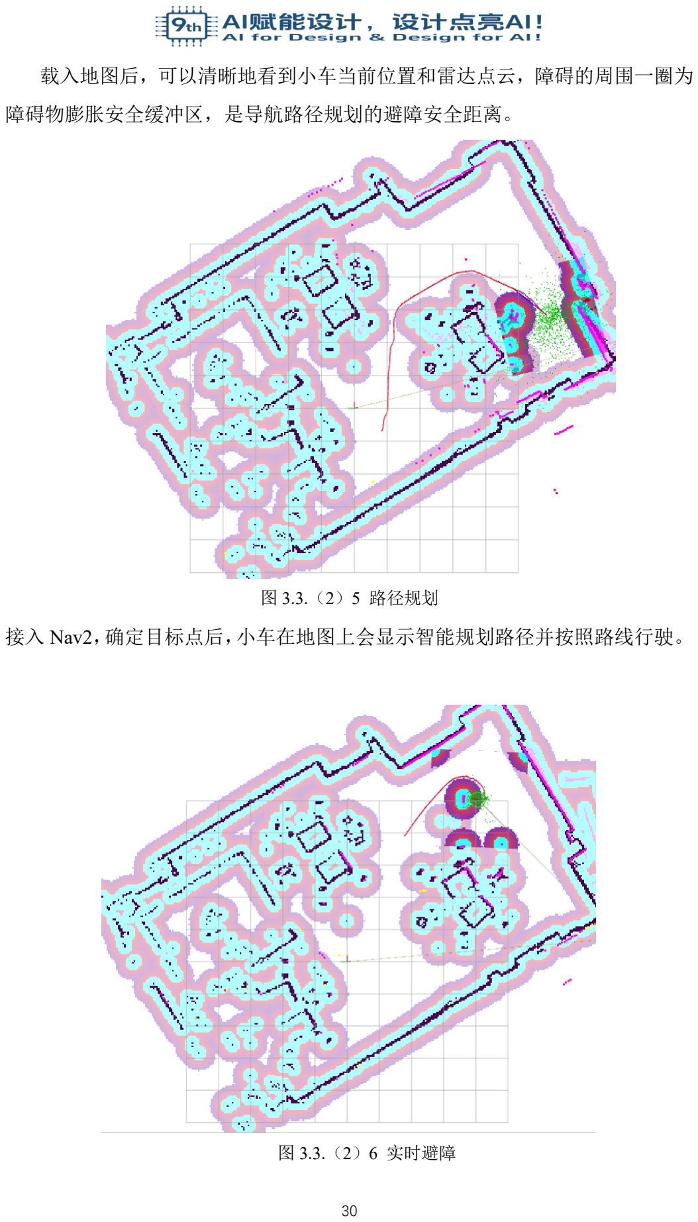
[picture p29: page 30]

载入地图后，可以清晰地看到小车当前位置和雷达点云，障碍的周围一圈为

障碍物膨胀安全缓冲区，是导航路径规划的避障安全距离。

图 3.3.（2）5 路径规划

接入 Nav2，确定目标点后，小车在地图上会显示智能规划路径并按照路线行驶。

图 3.3.（2）6 实时避障

面对地图上出现的障碍，雷达探测到之后返回 elf2 开发板，能利用算法进行

实时避障。

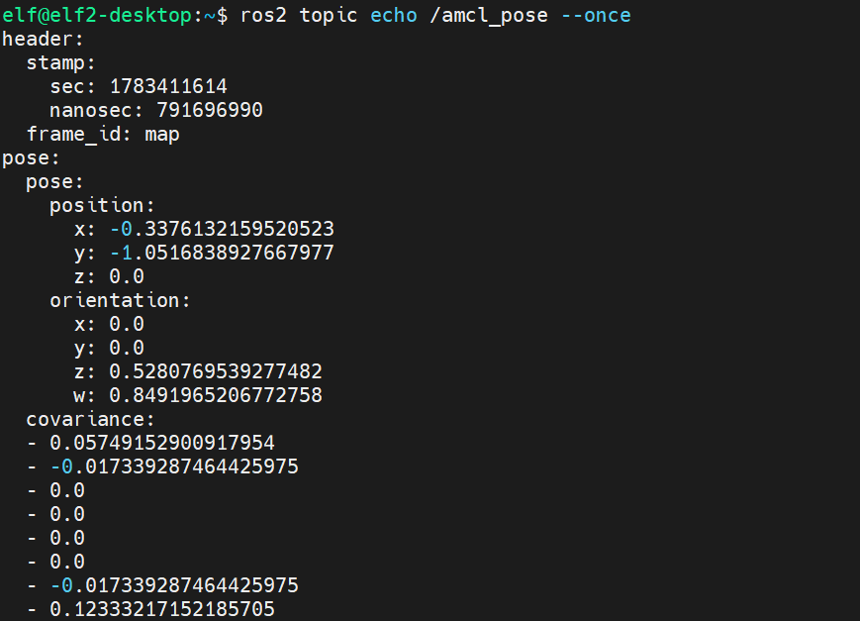
[picture p30: figure]

图 3.3.（2）7 AMCL 定位

通过订阅 AMCL 输出的/amcl_pose 话题，可实时读取机器人在全局栅格地

图中的二维坐标与航向角，通过编写程序加入目的地坐标和航向角，无需在 rviz2

软件中调度，让小车自动驶向指定目标点。

（3）跌倒检测模型部署

采用 PyTorch 完成模型训练，经转换 ONNX，再次转换为 rknn 后部署至

RK3588NPU，实现边缘端实时跌倒检测。

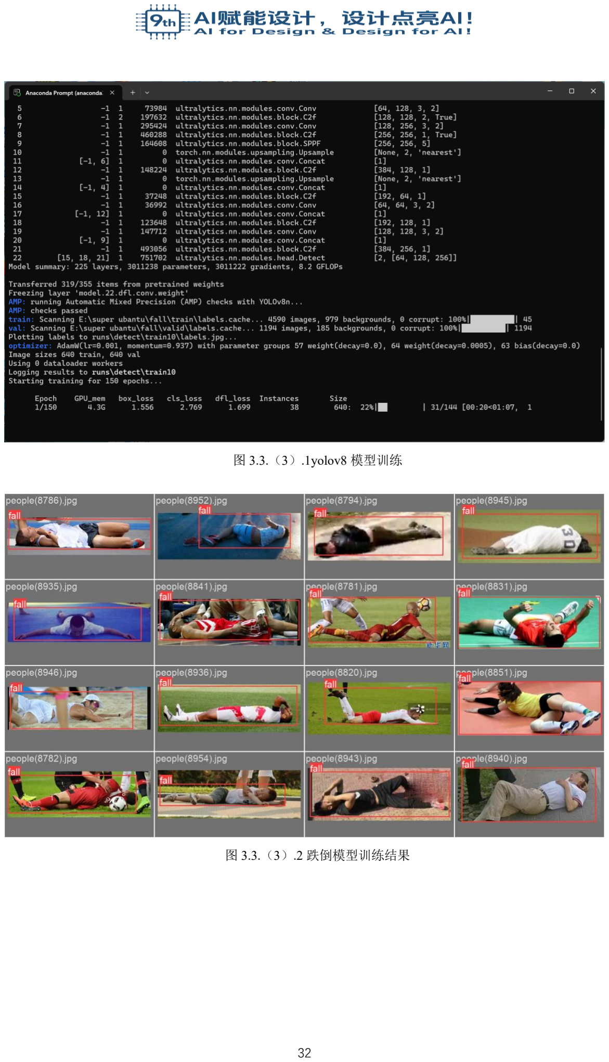
[picture p31: page 32]

图 3.3.（3）.1yolov8 模型训练

图 3.3.（3）.2 跌倒模型训练结果

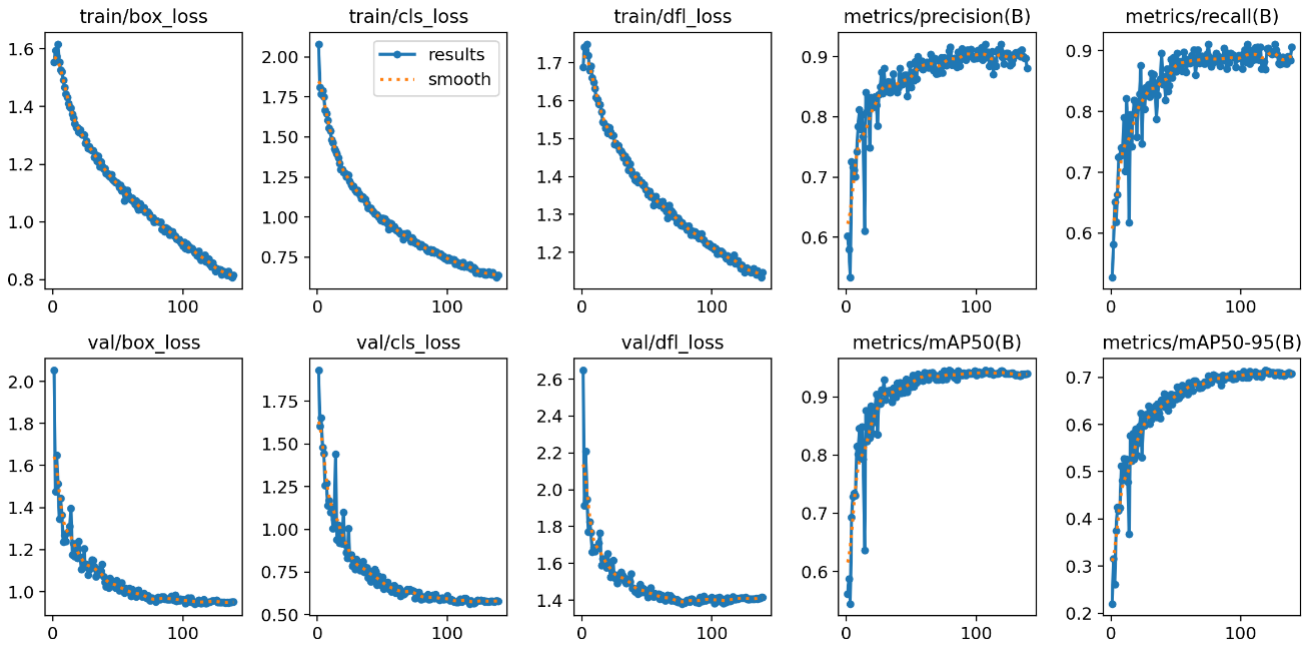
[picture p32: figure]

图 3.3.（3）.2 跌倒模型学习曲线与性能指标图

子图标签 | 含义 | 说明
train/box_loss | 训练集边界框回归损失 | 衡量预测框与真实框的坐标误差 （如 CIoU、GIoU 等）。下降趋势 正常，说明模型在学习定位。
train/cls_loss | 训练集分类损失 | 衡量类别预测的交叉熵误差。持 续下降→分类能力提升。
train/dfl_loss | 训练集分布焦点损失 （DistributionFocalLoss） | 常见于YOLOv8/v9等使用DFL的 模型，用于优化边界框回归的分 布建模（替代传统 IoUloss），使 回归更平滑稳定。
metrics/precision(B) | 验证集精度 （Precision@IoU=0.5） | 正确检出的目标中，真正属于正 类的比例（避免误检）。值越高越 好，收敛到~0.9 表示高精度。
metrics/recall(B) | 验证集召回率 （Recall@IoU=0.5） | 所有真实目标中被成功检出的比 例（避免漏检）。值高说明覆盖全 面。
val/box_loss | 验证集边界框损失 | 若持续高于训练损失但同步下降 →泛化良好；若突然上升→过拟 合或数据分布偏移。
val/cls_loss | 验证集分类损失 | 同上，应平稳下降。
val/dfl_loss | 验证集 DFL 损失 | 关键指标：若验证 DFL 损失显著 高于训练（如>1.5 倍），可能过拟 合；此处趋势一致，健康。

metrics/mAP50(B) | 验证集平均精度 （mAP@0.5） | 核心综合指标：IoU 阈值为 0.5 时 的平均精度。>0.9表示模型非常优 秀（常见于 COCOval 上 YOLOv8n 可达 0.38，但你的任务可能是小数 据集/简单场景，故更高）。
metrics/mAP50-95(B) | 验证集平均精度 （mAP@[0.5:0.95]） | 更严格的指标：IoU 从 0.5 到 0.95 步长 0.05 取平均。反映模型 对定位精度要求高的鲁棒性。值 ≈0.7 表明模型在高 IoU 下仍较可 靠。

模型训练成功，损失函数全部收敛所有 train 和 val 损失均随 epoch 下降并趋

于稳定（无震荡、无发散），说明优化稳定。训练/验证损失差距小，无明显过拟

合。

性能指标上：

mAP50≈0.92，几乎所有目标在 IoU≥0.5 时都能正确检出；

mAP50-95≈0.70，即使要求严格（IoU≥0.75），仍有较高检出质量；

Precision&Recall 均>0.85，平衡了“少漏检”和“少误检”。

DFL 损失表现健康，dfl_loss 在训练/验证中同步下降，且验证损失未异常升

高，说明 DFL 机制有效提升了回归稳定性，没有因分布建模引入噪声。

编写 python 文件验证模型。

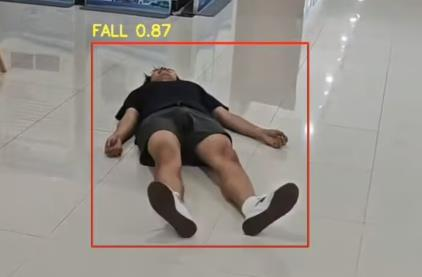
[picture p33: figure]

图 3.3.（3）.3 跌倒模型 fall.pt 验证结果

经过初步的验证，训练的跌倒 fall.pt 模型可以正确识别人物的跌倒，下一步

就是在 x86 平台把 pt 模型转化格式为 onnx 格式，再在虚拟机上把 onnx 格式模

型转化为 rknn 格式。

经过转化之后，rknn 格式的模型可以正常运行在 ELF2 开发板上，使用图片

进行初步验证。

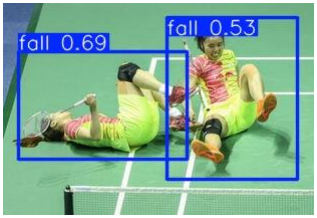
[picture p34: figure]

图 3.3.（3）.4 跌倒模型 fall.rknn 图片验证结果

之后，我们通过网络串流，使 ELF2 开发板可以获取远程摄像头的视频流，

并编写 python 文件对摄像头回传的图像进行实时的跌倒检测。

由于小车使用 wifi 连接，经过实验分析后，发现回传主机的模型检测结果存

在一定的网络延迟，为了结果绝对准确，我们在 ELF2 开发板外接了屏幕进行验

证。

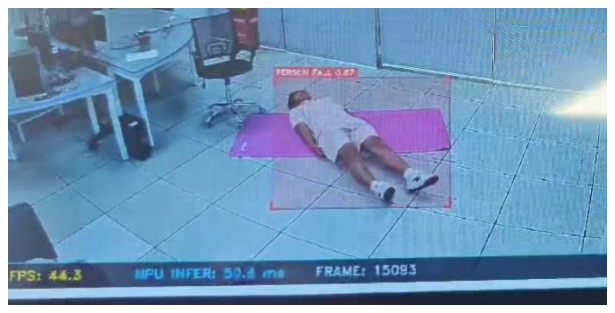
[picture p35: figure]
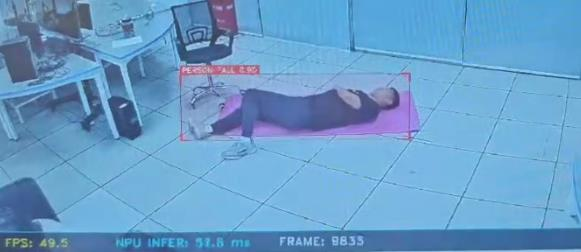
[picture p36: figure]

图 3.3.（3）.5 跌倒模型 fall.rknn 视频多次验证结果

经过反复实验验证，fall.rknn跌倒检测模型可以完美运行在ELF2开发板上。

第四部分总结

4.1 可扩展之处

环境感知方面，目前主要依赖 LD06 二维激光雷达完成建图、定位及避

障，后续可集成 3D 深度相机，识别障碍物高度、体积和空间结构，弥补二

维激光雷达对悬空及低矮障碍物的感知不足；同时，可增加超声波测距模块，

与激光雷达融合，实现近距离盲区检测，提升避障精度。

运动控制方面，可集成惯性测量单元（IMU），实时检测车体姿态与地形

坡度，自适应调整驱动参数，确保在斜坡、颠簸等复杂地形下的行驶稳定性。

此外，系统还可扩展多目标识别、多车协同调度、5G 远程控制及云平台

数据管理，满足智慧医院、智慧校园及大型公共场所应急救援需求，为智能

急救系统提供技术基础。

4.2 心得体会

本项目从立项到完成经历了需求分析、硬件搭建、底层驱动开发、人工智能

模型训练、自主导航部署以及整车联调等多个阶段，是一次理论与实践深度结合

的开发过程，也让团队成员对嵌入式系统、机器人控制和人工智能技术有了更加

全面的认识。

项目初期，我们首先完成了 STM32 底层控制系统的开发，实现了 PWM 驱

动、编码器测速、电机 PID 闭环控制等基础功能。由于编码器测速受采样周期、

机械误差以及参数整定等因素影响，车辆初期运行存在速度不一致、直线行驶偏

移等问题。我们通过反复调整 PID 参数，优化测速算法，并结合大量实验不断改

进控制策略，使底盘运动逐渐趋于稳定，为后续自主导航提供了可靠的运动基础。

在完成底层控制后，我们开始搭建 ROS2 开发环境，利用 LD06 激光雷达完

成环境建图、定位及导航功能。由于激光雷达安装角度、底盘运动误差以及地图

质量都会影响导航效果，我们多次调整雷达安装位置，优化建图流程，并不断修

改导航参数，最终实现了较稳定的自主导航和自动返航功能。

人工智能部分是本项目难度最大的内容之一。我们自行采集并整理跌倒检测

数据集，利用 PyTorch 完成模型训练，并不断调整网络参数，提高模型识别准确

率。随后按照 PT 模型、ONNX 模型到 RKNN 模型的流程完成模型转换，并部署

到飞凌 ELF2（RK3588）开发板的 NPU 进行推理。在模型部署过程中，我们遇

到了算子不兼容、模型转换失败以及误识别等问题，通过查阅官方文档、分析日

志和不断调试，最终成功实现模型在边缘设备上的实时运行。

系统联调阶段也是整个项目最具挑战性的环节。由于 STM32、ELF2、激光

雷达、语音播报等多个模块需要协同工作，一个模块出现异常都会影响整车运行。

团队针对串口通信、ROS 节点通信、导航控制及任务调度进行了大量测试，对系

统进行了多轮优化，提高了整体稳定性和响应速度。

通过本项目的研发，我们不仅掌握了 STM32 嵌入式开发、ROS2 机器人开

发、激光雷达导航、深度学习模型训练与部署等关键技术，也进一步提升了查阅

资料、自主学习、团队协作以及分析和解决工程问题的能力。未来，我们计划继

续完善系统功能，引入 3D 深度相机、多传感器融合和智能调度算法，不断提高

系统的智能化水平，为公共应急救援提供更加高效、可靠的解决方案。

第五部分参考文献

[1]STMicroelectronics.STM32F103x8/BSTM32F103xC/D/EReferenceManual(RM000

8)[EB/OL].STMicroelectronics,2024.

[2]STMicroelectronics.STM32F103x8/BDatasheet[EB/OL].STMicroelectronics,2024.

[3]RockchipElectronicsCo.,Ltd.RK3588TechnicalReferenceManual[EB/OL].Rockchi

p,2024.

[4]RockchipElectronicsCo.,Ltd.RKNNToolkit2UserGuide[EB/OL].Rockchip,2024.

[5]保定飞凌嵌入式技术有限公司.ELF2（RK3588）开发板用户手册[M/OL].保定：

飞凌嵌入式，2024.

[6]保定飞凌嵌入式技术有限公司.RK3588 开发板硬件设计与开发资料[M/OL].保

定：飞凌嵌入式，2024.

[7]EAITechnology.LD06LiDARUserManual[EB/OL].EAITechnology,2024.

[8]QuigleyM,ConleyK,GerkeyB,etal.ROS:AnOpen-

SourceRobotOperatingSystem[C].ICRAWorkshoponOpenSourceSoftware.Kobe,Japa

n,2009.

[9]MacenskiS,SinghS,MartinF,etal.TheMarathon2:ANavigationSystem[J].JournalofO

penSourceSoftware,2020,5(52):2515.

[10]PaszkeA,GrossS,MassaF,etal.PyTorch:AnImperativeStyle,High-

PerformanceDeepLearningLibrary[C]AdvancesinNeuralInformationProcessingSyste

ms.2019.

[11]BaiJ,LuF,ZhangK,etal.ONNX:OpenNeuralNetworkExchange[EB/OL].LinuxFoun

dation,2019.

[12]JocherG,ChaurasiaA,QiuJ.UltralyticsYOLO[EB/OL].Ultralytics,2024.

[13]GoodfellowI,BengioY,CourvilleA.DeepLearning[M].Cambridge:MITPress,2016.

[14]ThrunS,BurgardW,FoxD.ProbabilisticRobotics[M].Cambridge:MITPress,2005.

[15]AstromKJ,MurrayRM.FeedbackSystems:AnIntroductionforScientistsandEngineer

s[M].Princeton:PrincetonUniversityPress,2008.

[16]胡春旭.ROS 机器人开发实践[M].北京：机械工业出版社，2021.
