giaogiaooo/AED-Rescue-Vehicle-system/fall/train/confusion_matrix.png

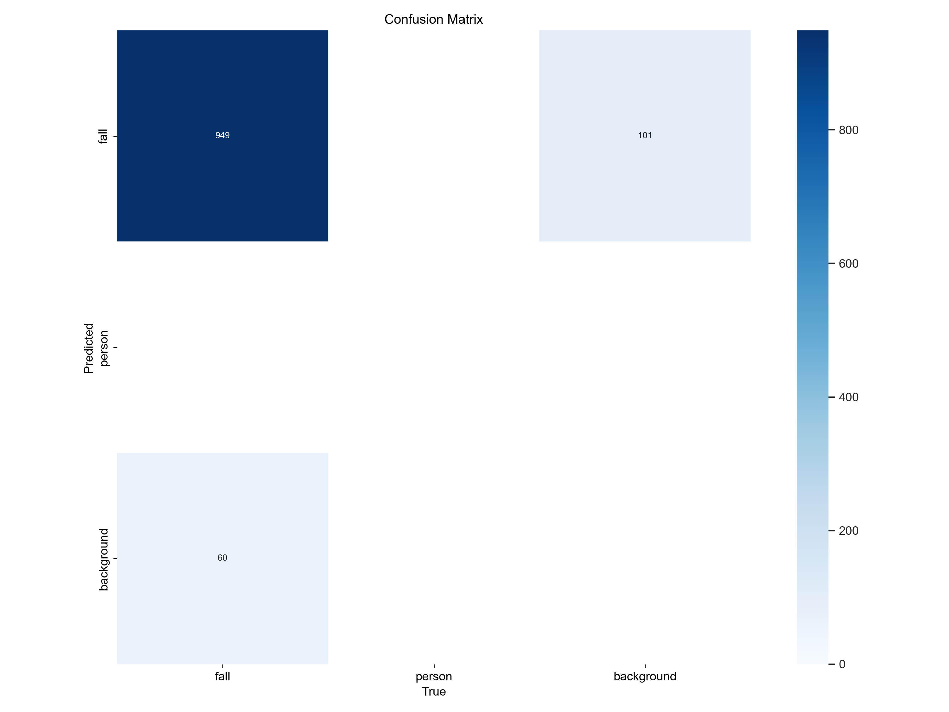
fall/train/confusion_matrix.png
