giaogiaooo/AED-Rescue-Vehicle-system/fall/train/F1_curve.png

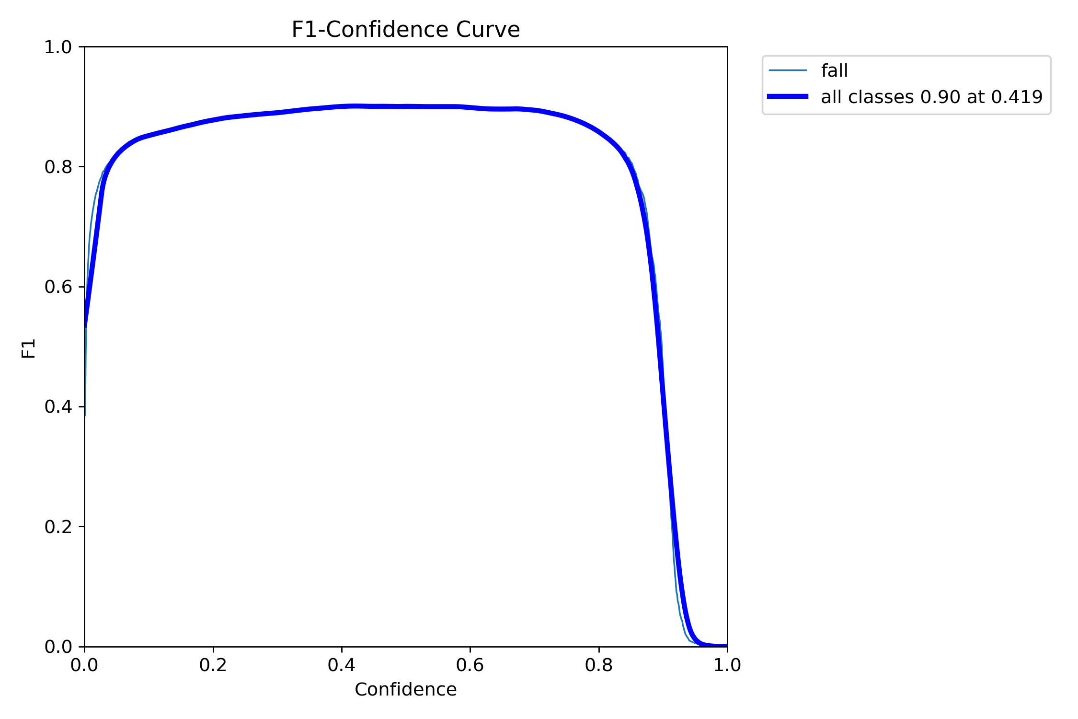
fall/train/F1_curve.png
