giaogiaooo/AED-Rescue-Vehicle-system/fall/train/labels.jpg

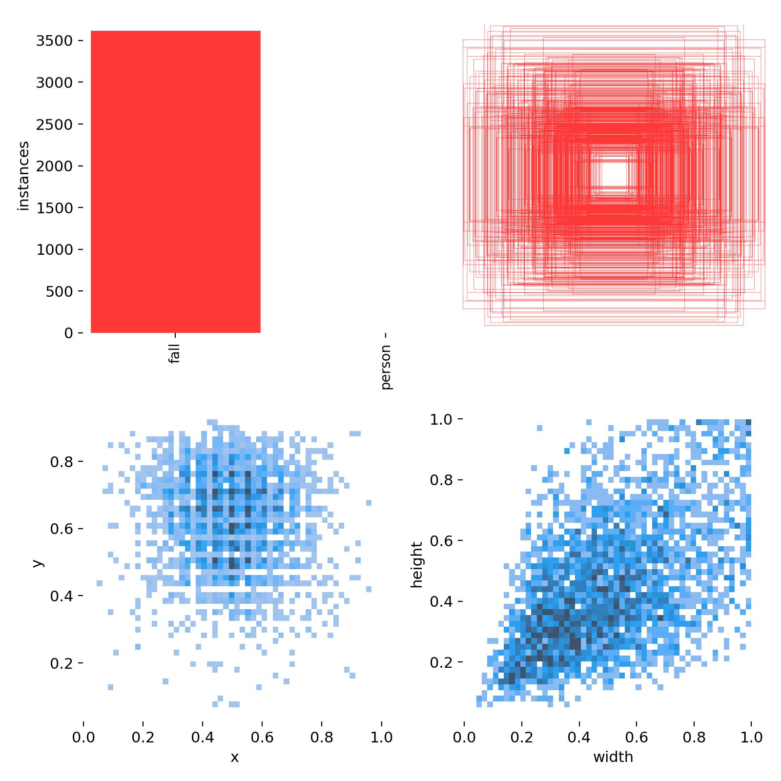
fall/train/labels.jpg
