giaogiaooo/AED-Rescue-Vehicle-system/fall/train/labels_correlogram.jpg

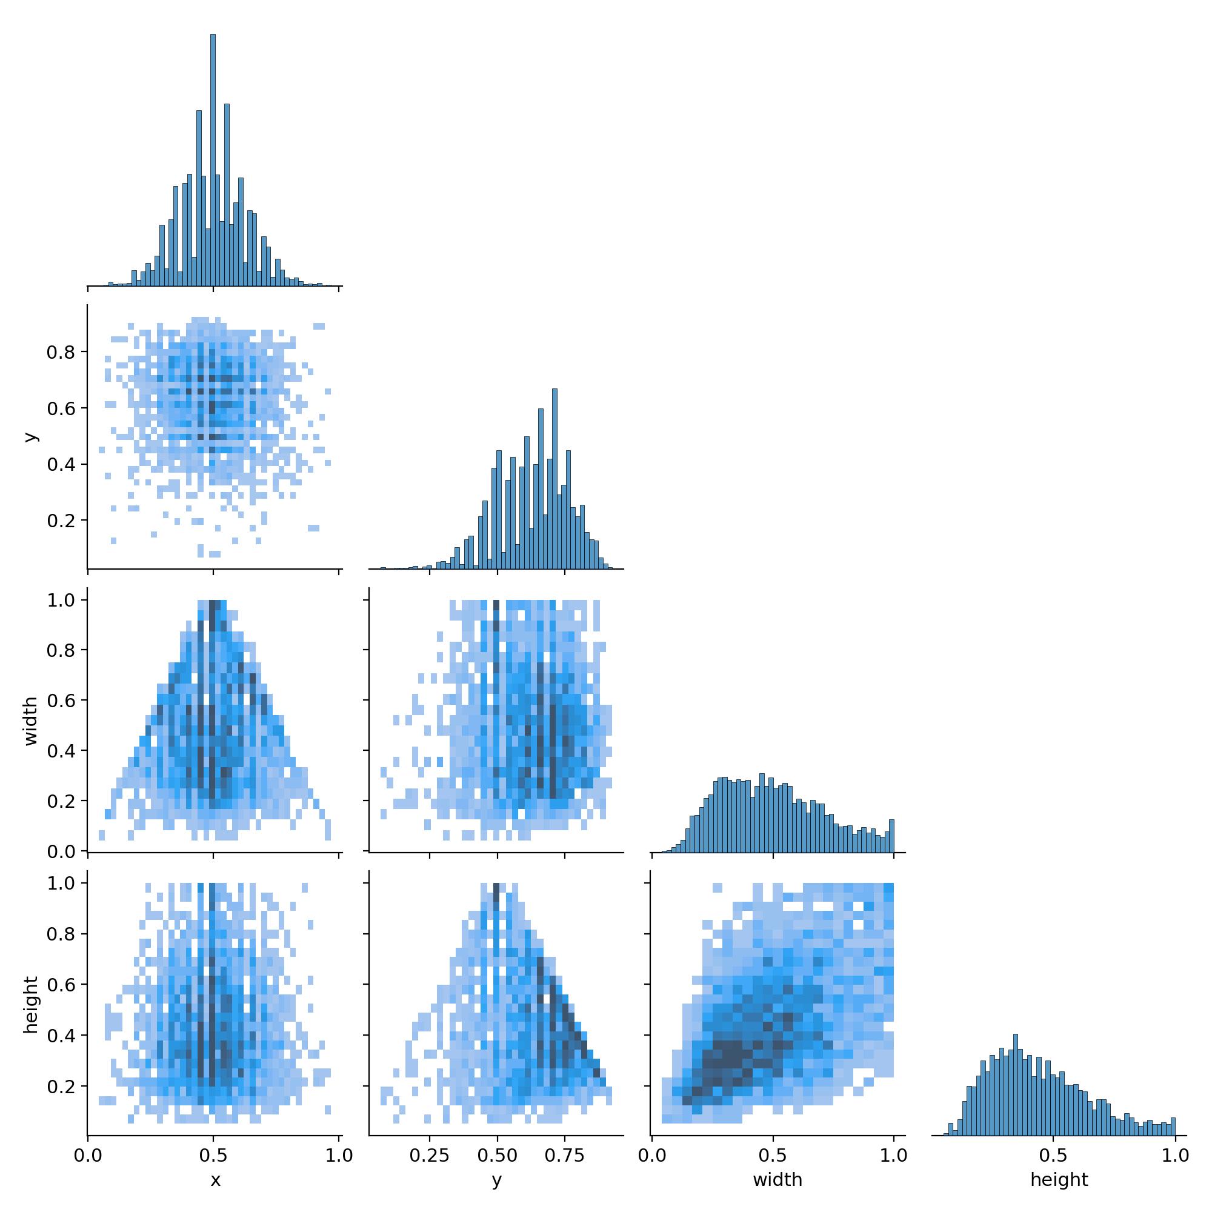
fall/train/labels_correlogram.jpg
