giaogiaooo/AED-Rescue-Vehicle-system/fall/train/P_curve.png

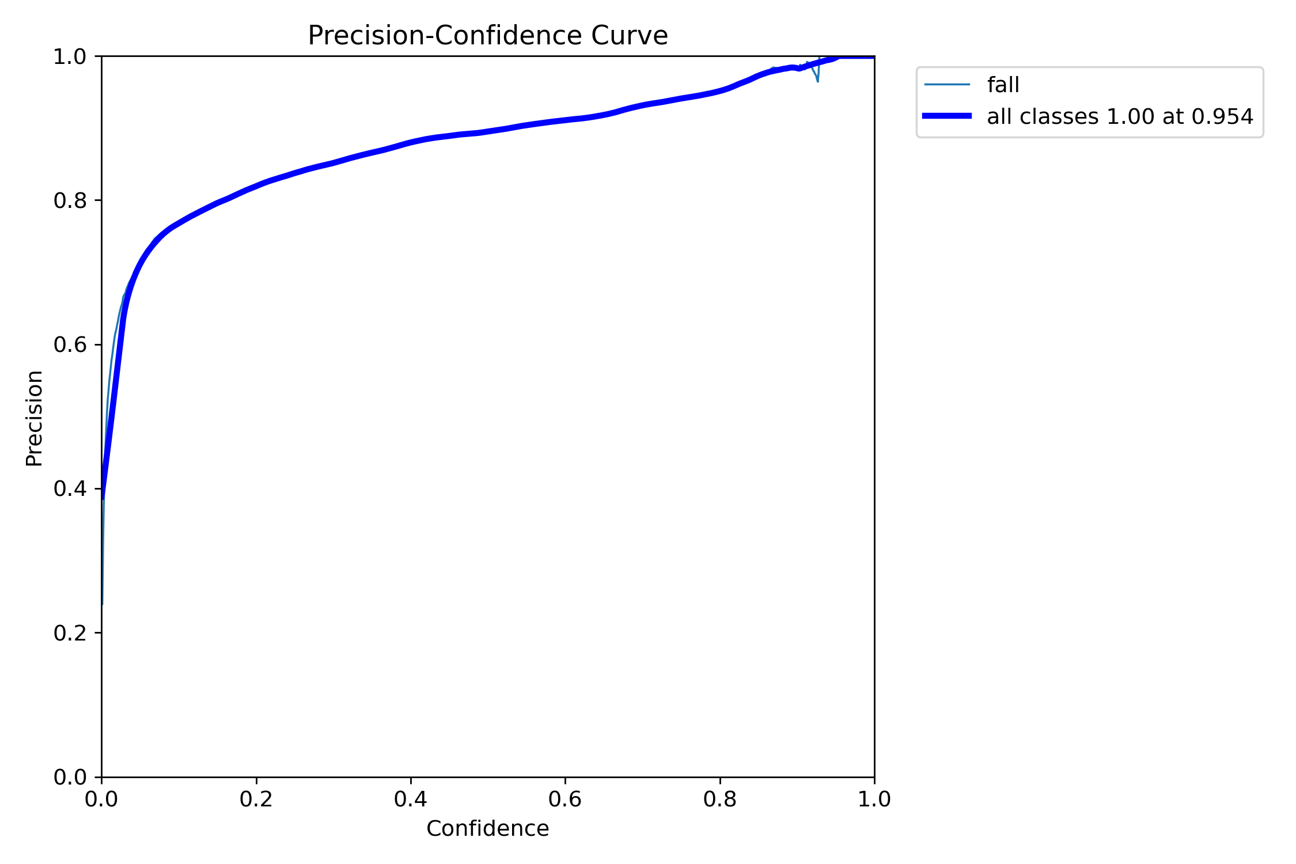
fall/train/P_curve.png
