giaogiaooo/AED-Rescue-Vehicle-system/fall/train/PR_curve.png

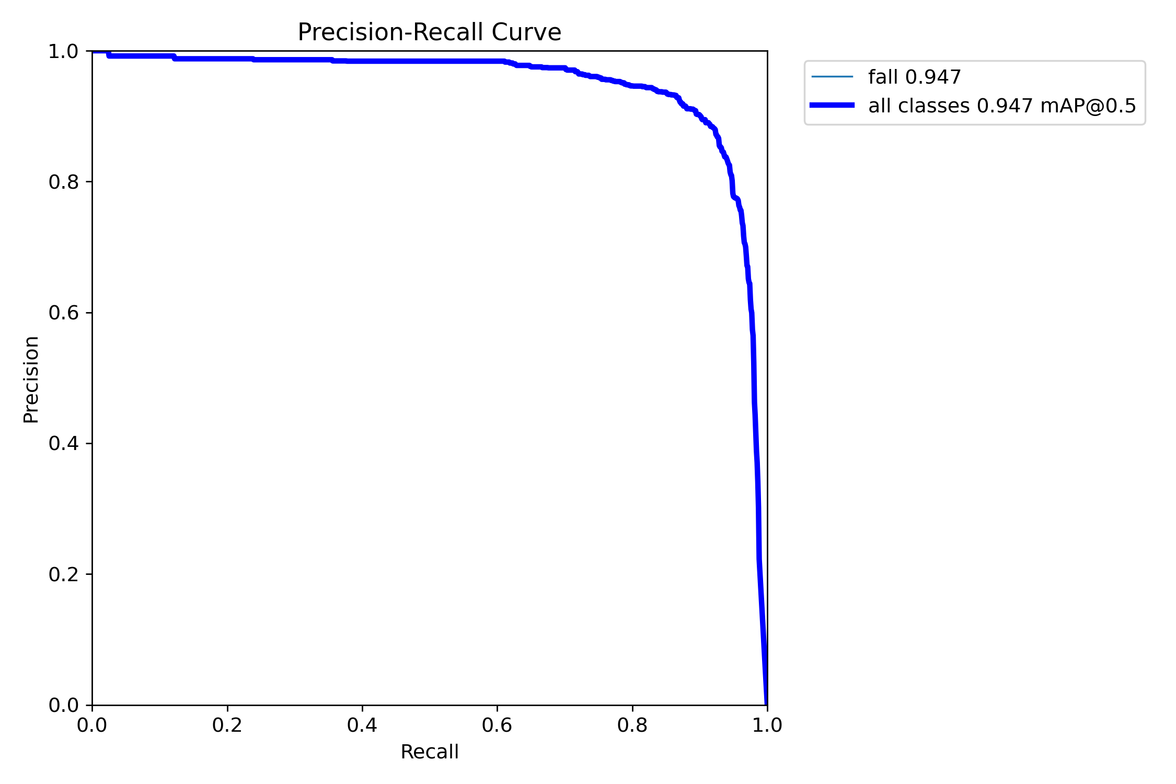
fall/train/PR_curve.png
