giaogiaooo/AED-Rescue-Vehicle-system/fall/train/train_batch0.jpg

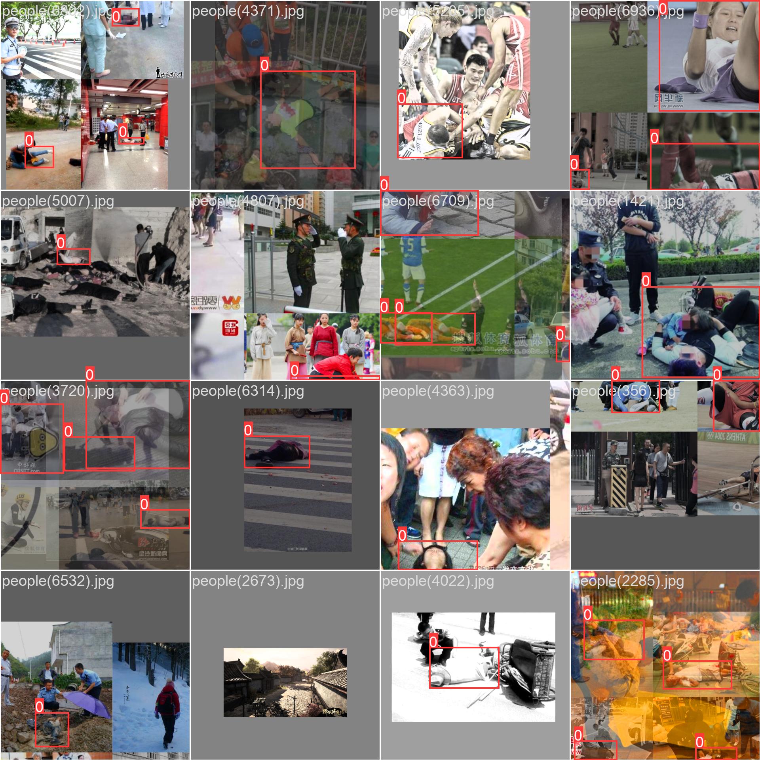
fall/train/train_batch0.jpg
