giaogiaooo/AED-Rescue-Vehicle-system/fall/train/train_batch2.jpg

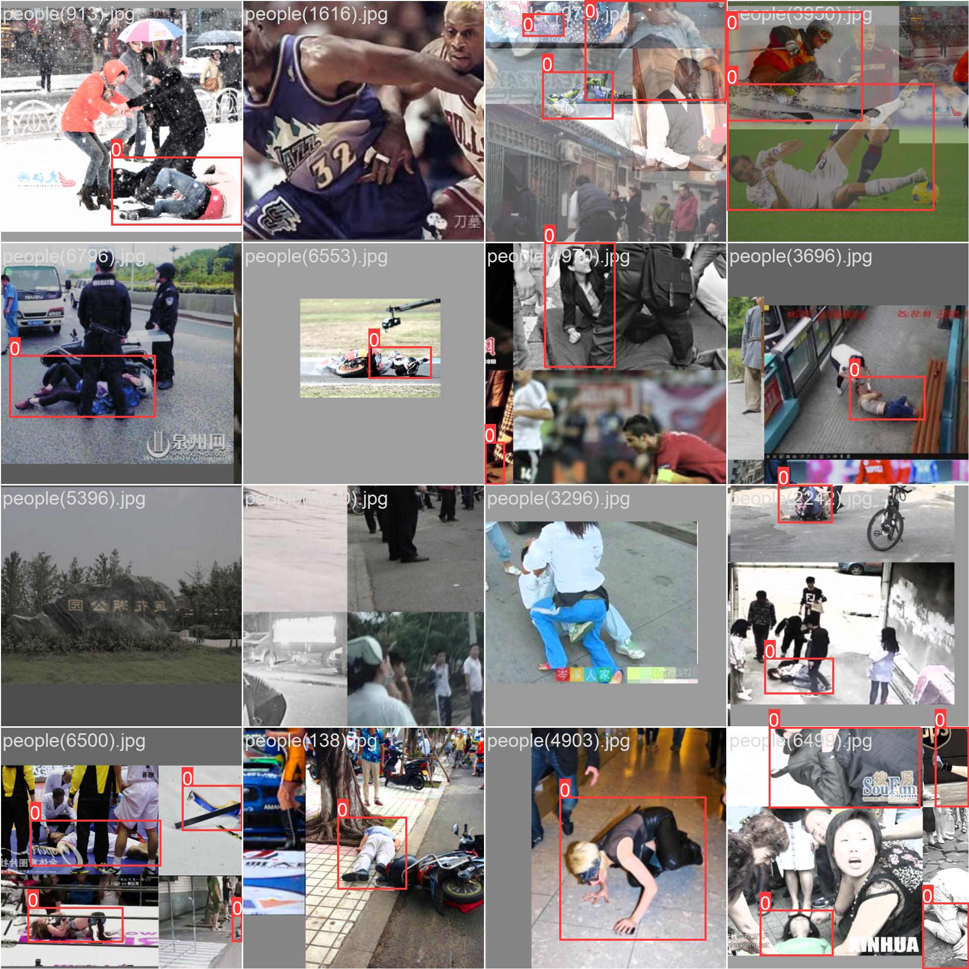
fall/train/train_batch2.jpg
