giaogiaooo/AED-Rescue-Vehicle-system/fall/train/val_batch0_labels.jpg

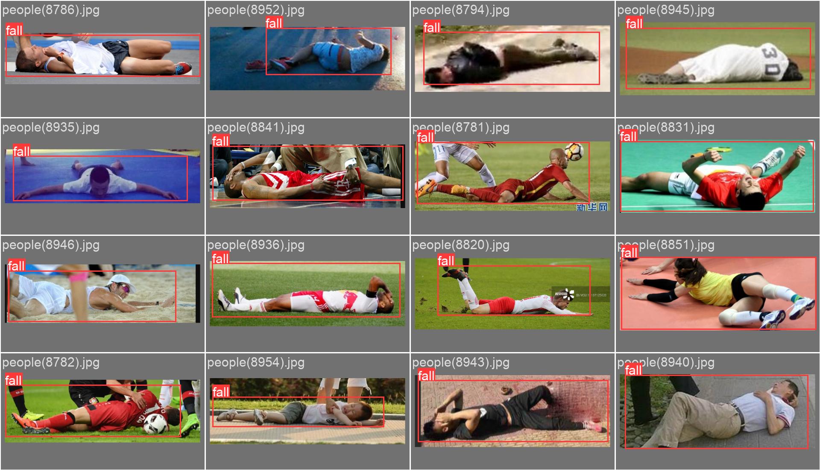
fall/train/val_batch0_labels.jpg
