giaogiaooo/AED-Rescue-Vehicle-system/fall/train/val_batch1_labels.jpg

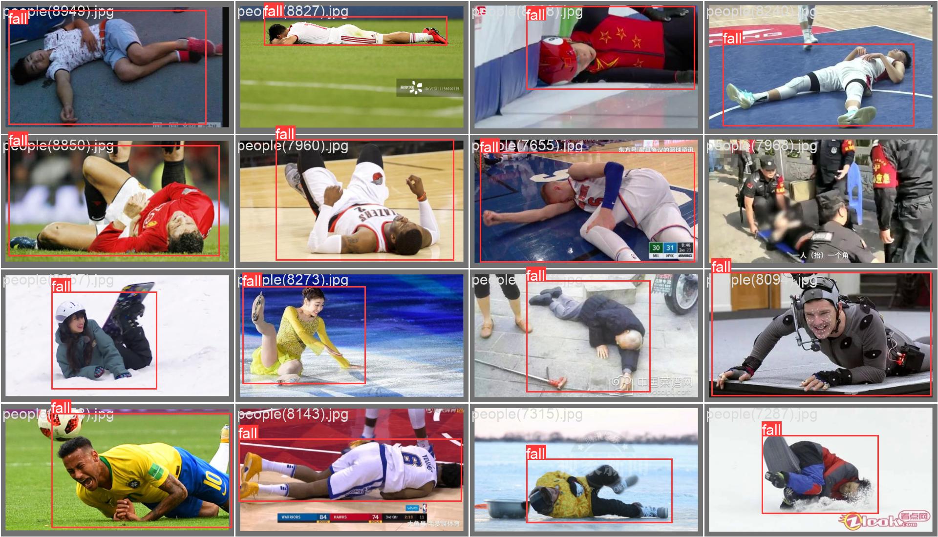
fall/train/val_batch1_labels.jpg
