giaogiaooo/AED-Rescue-Vehicle-system/fall/train/results.png

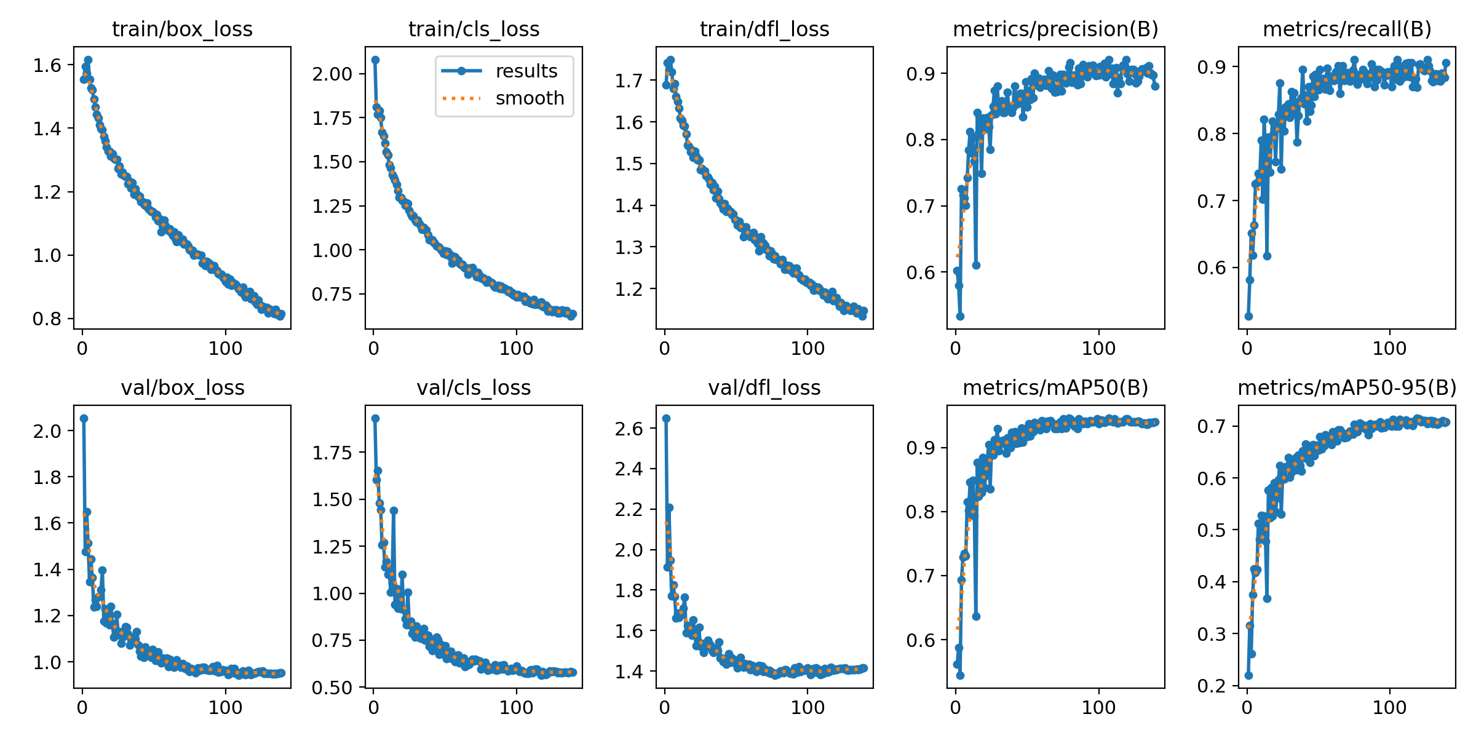
fall/train/results.png
