giaogiaooo/AED-Rescue-Vehicle-system/stm32/Core/Src/main.c

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
/* Includes ------------------------------------------------------------------*/
#include "main.h"

/* USER CODE BEGIN Includes */
#include <stdlib.h>
#include <math.h>
/* USER CODE END Includes */

/* USER CODE BEGIN PD */
#define ENCODER_PPR 1320.0f
#define CTRL_DT_S   0.02f
/* USER CODE END PD */

TIM_HandleTypeDef htim1;
TIM_HandleTypeDef htim2;
TIM_HandleTypeDef htim3;
TIM_HandleTypeDef htim4;
TIM_HandleTypeDef htim5;
TIM_HandleTypeDef htim8;

UART_HandleTypeDef huart1;

/* USER CODE BEGIN PV */

uint8_t rx_buffer[10];
uint8_t rx_byte;
uint8_t rx_idx = 0;

volatile int16_t target_vx = 0;
volatile int16_t target_vy = 0;
volatile int16_t target_w  = 0;

volatile uint32_t last_cmd_time = 0; // 看门狗安全时间戳
uint32_t last_ctrl_time = 0;
uint32_t last_upload_time = 0;       // 编码器上传调度时间戳

uint8_t tx_buffer[12];

// ==================== 2. PID 与电机闭环结构体 ====================
typedef struct {
    float Kp, Ki, Kd;
    float err, last_err, integral;
    float max_integral, max_out;
} PID_TypeDef;

typedef struct {
    PID_TypeDef pid;
    float target_rpm;
    float current_rpm;
    int16_t pwm_out;
    int16_t enc_delta;  // 20ms 内的原始脉冲增量
} Motor_TypeDef;

// 数组映射: 0:左前(LF), 1:右前(RF), 2:左后(LR), 3:右后(RR)
Motor_TypeDef motors[4];
/* USER CODE END PV */

void SystemClock_Config(void);
static void MX_GPIO_Init(void);
static void MX_TIM3_Init(void);
static void MX_TIM4_Init(void);
static void MX_USART1_UART_Init(void);
static void MX_TIM2_Init(void);
static void MX_TIM5_Init(void);
static void MX_TIM1_Init(void);
static void MX_TIM8_Init(void);
/* USER CODE BEGIN PFP */
// ==================== 闭环控制核心函数声明 ====================
void PID_Init(void);
void Control_Task_20ms(void);
void Kinematics_Update(void);
void Encoder_Update(void);
void PID_Update(void);
float PID_Calc(PID_TypeDef *pid, float target, float measure);
void Chassis_SetPWM(int speed_lf, int speed_lr, int speed_rf, int speed_rr);
/* USER CODE END PFP */

/* USER CODE BEGIN 0 */
// ==================== 控制系统完整实现 ====================


void PID_Init(void) {
    for (int i = 0; i < 4; i++) {
        motors[i].pid.Kp = 1.2f;
        motors[i].pid.Ki = 0.1f;
        motors[i].pid.Kd = 0.02f;
        motors[i].pid.max_out = 100.0f;
        motors[i].pid.max_integral = 50.0f;

        motors[i].pid.integral = 0.0f;
        motors[i].pid.last_err = 0.0f;
        motors[i].target_rpm = 0.0f;
        motors[i].current_rpm = 0.0f;
        motors[i].pwm_out = 0;
    }
}


void Kinematics_Update(void) {

    __disable_irq();
    int16_t vx = target_vx;
    int16_t vy = target_vy;
    int16_t w  = target_w;
    __enable_irq();

    // 500ms 看门狗：断联自动停车
    if (HAL_GetTick() - last_cmd_time > 500) {
        vx = 0; vy = 0; w = 0;
    }


    motors[0].target_rpm = vx + vy - w; // 0: LF
    motors[1].target_rpm = vx - vy + w; // 1: RF
    motors[2].target_rpm = vx - vy - w; // 2: LR
    motors[3].target_rpm = vx + vy + w; // 3: RR
}

// 3. 编码器测速：读取脉冲并转换为真实 RPM
void Encoder_Update(void) {
    // 读取原始脉冲
    motors[0].enc_delta = (int16_t)__HAL_TIM_GET_COUNTER(&htim1); // LF
    motors[1].enc_delta = (int16_t)__HAL_TIM_GET_COUNTER(&htim2); // RF
    motors[2].enc_delta = (int16_t)__HAL_TIM_GET_COUNTER(&htim5); // LR
    motors[3].enc_delta = (int16_t)__HAL_TIM_GET_COUNTER(&htim8); // RR


    __HAL_TIM_SET_COUNTER(&htim1, 0);
    __HAL_TIM_SET_COUNTER(&htim2, 0);
    __HAL_TIM_SET_COUNTER(&htim5, 0);
    __HAL_TIM_SET_COUNTER(&htim8, 0);


    float rpm_coeff = (1.0f / CTRL_DT_S) * 60.0f / ENCODER_PPR;
    for(int i = 0; i < 4; i++) {
        motors[i].current_rpm = motors[i].enc_delta * rpm_coeff;
    }
}


void PID_Update(void) {
    for (int i = 0; i < 4; i++) {
        motors[i].pwm_out = (int16_t)PID_Calc(&motors[i].pid, motors[i].target_rpm, motors[i].current_rpm);
    }
}

// 5. 组装 20ms 完整控制任务
void Control_Task_20ms(void) {
    Kinematics_Update();  // 步骤 A: 刷新四轮 target_rpm
    Encoder_Update();     // 步骤 B: 刷新四轮 current_rpm
    PID_Update();         // 步骤 C: 计算四轮 pwm_out


    Chassis_SetPWM(motors[0].pwm_out, motors[2].pwm_out, motors[1].pwm_out, motors[3].pwm_out);
}

// 6. PID 核心算式实现
float PID_Calc(PID_TypeDef *pid, float target, float measure) {
    pid->err = target - measure;

    pid->integral += pid->err;
    if (pid->integral > pid->max_integral) pid->integral = pid->max_integral;
    else if (pid->integral < -pid->max_integral) pid->integral = -pid->max_integral;

    float out = (pid->Kp * pid->err) + (pid->Ki * pid->integral) + (pid->Kd * (pid->err - pid->last_err));
    pid->last_err = pid->err;

    if (out > pid->max_out) out = pid->max_out;
    else if (out < -pid->max_out) out = -pid->max_out;

    return out;
}

// 7. AT8236 底层 PWM 映射
void Chassis_SetPWM(int speed_lf, int speed_lr, int speed_rf, int speed_rr) {
    uint32_t arr_val = __HAL_TIM_GET_AUTORELOAD(&htim4) + 1; // 修正 ARR 获取

    if(speed_lf > 100) speed_lf = 100; else if(speed_lf < -100) speed_lf = -100;
    if(speed_lr > 100) speed_lr = 100; else if(speed_lr < -100) speed_lr = -100;
    if(speed_rf > 100) speed_rf = 100; else if(speed_rf < -100) speed_rf = -100;
    if(speed_rr > 100) speed_rr = 100; else if(speed_rr < -100) speed_rr = -100;

    uint32_t pwm_lf = (abs(speed_lf) * arr_val) / 100;
    uint32_t pwm_lr = (abs(speed_lr) * arr_val) / 100;
    uint32_t pwm_rf = (abs(speed_rf) * arr_val) / 100;
    uint32_t pwm_rr = (abs(speed_rr) * arr_val) / 100;

    // 左前 (TIM4 CH1/2) - PD12/PD13
    if (speed_lf > 0) { __HAL_TIM_SET_COMPARE(&htim4, TIM_CHANNEL_1, pwm_lf); __HAL_TIM_SET_COMPARE(&htim4, TIM_CHANNEL_2, 0); }
    else if (speed_lf < 0) { __HAL_TIM_SET_COMPARE(&htim4, TIM_CHANNEL_1, 0); __HAL_TIM_SET_COMPARE(&htim4, TIM_CHANNEL_2, pwm_lf); }
    else { __HAL_TIM_SET_COMPARE(&htim4, TIM_CHANNEL_1, 0); __HAL_TIM_SET_COMPARE(&htim4, TIM_CHANNEL_2, 0); }

    // 左后 (TIM4 CH3/4) - PD14/PD15
    if (speed_lr > 0) { __HAL_TIM_SET_COMPARE(&htim4, TIM_CHANNEL_3, pwm_lr); __HAL_TIM_SET_COMPARE(&htim4, TIM_CHANNEL_4, 0); }
    else if (speed_lr < 0) { __HAL_TIM_SET_COMPARE(&htim4, TIM_CHANNEL_3, 0); __HAL_TIM_SET_COMPARE(&htim4, TIM_CHANNEL_4, pwm_lr); }
    else { __HAL_TIM_SET_COMPARE(&htim4, TIM_CHANNEL_3, 0); __HAL_TIM_SET_COMPARE(&htim4, TIM_CHANNEL_4, 0); }

    // 右前 (TIM3 CH1/2) - PA6/PA7
    if (speed_rf > 0) { __HAL_TIM_SET_COMPARE(&htim3, TIM_CHANNEL_1, 0); __HAL_TIM_SET_COMPARE(&htim3, TIM_CHANNEL_2, pwm_rf); }
    else if (speed_rf < 0) { __HAL_TIM_SET_COMPARE(&htim3, TIM_CHANNEL_1, pwm_rf); __HAL_TIM_SET_COMPARE(&htim3, TIM_CHANNEL_2, 0); }
    else { __HAL_TIM_SET_COMPARE(&htim3, TIM_CHANNEL_1, 0); __HAL_TIM_SET_COMPARE(&htim3, TIM_CHANNEL_2, 0); }

    // 右后 (TIM3 CH3/4) - PB0/PB1
    if (speed_rr > 0) { __HAL_TIM_SET_COMPARE(&htim3, TIM_CHANNEL_3, 0); __HAL_TIM_SET_COMPARE(&htim3, TIM_CHANNEL_4, pwm_rr); }
    else if (speed_rr < 0) { __HAL_TIM_SET_COMPARE(&htim3, TIM_CHANNEL_3, pwm_rr); __HAL_TIM_SET_COMPARE(&htim3, TIM_CHANNEL_4, 0); }
    else { __HAL_TIM_SET_COMPARE(&htim3, TIM_CHANNEL_3, 0); __HAL_TIM_SET_COMPARE(&htim3, TIM_CHANNEL_4, 0); }
}
/* USER CODE END 0 */

/**
  * @brief  The application entry point.
  * @retval int
  */
int main(void)
{
  /* MCU Configuration--------------------------------------------------------*/

  /* Reset of all peripherals, Initializes the Flash interface and the Systick. */
  HAL_Init();

  /* Configure the system clock */
  SystemClock_Config();

  /* Initialize all configured peripherals */
  MX_GPIO_Init();
  MX_TIM3_Init();
  MX_TIM4_Init();
  MX_USART1_UART_Init();
  MX_TIM2_Init();
  MX_TIM5_Init();
  MX_TIM1_Init();
  MX_TIM8_Init();
  /* USER CODE BEGIN 2 */

  PID_Init();


  HAL_TIM_PWM_Start(&htim4, TIM_CHANNEL_1); HAL_TIM_PWM_Start(&htim4, TIM_CHANNEL_2);
  HAL_TIM_PWM_Start(&htim4, TIM_CHANNEL_3); HAL_TIM_PWM_Start(&htim4, TIM_CHANNEL_4);
  HAL_TIM_PWM_Start(&htim3, TIM_CHANNEL_1); HAL_TIM_PWM_Start(&htim3, TIM_CHANNEL_2);
  HAL_TIM_PWM_Start(&htim3, TIM_CHANNEL_3); HAL_TIM_PWM_Start(&htim3, TIM_CHANNEL_4);
  Chassis_SetPWM(0, 0, 0, 0);

  // 3. 启动 4 个编码器
  HAL_TIM_Encoder_Start(&htim1, TIM_CHANNEL_ALL);
  HAL_TIM_Encoder_Start(&htim2, TIM_CHANNEL_ALL);
  HAL_TIM_Encoder_Start(&htim5, TIM_CHANNEL_ALL);
  HAL_TIM_Encoder_Start(&htim8, TIM_CHANNEL_ALL);


  __HAL_UART_CLEAR_OREFLAG(&huart1);
  __HAL_UART_CLEAR_NEFLAG(&huart1);
  __HAL_UART_CLEAR_FEFLAG(&huart1);
  __HAL_UART_CLEAR_PEFLAG(&huart1);


  HAL_UART_Receive_IT(&huart1, &rx_byte, 1);


  last_ctrl_time = HAL_GetTick();
  last_upload_time = HAL_GetTick();
  last_cmd_time = HAL_GetTick();
  /* USER CODE END 2 */

  /* Infinite loop */
  /* USER CODE BEGIN WHILE */
  while (1)
  {
      uint32_t current_time = HAL_GetTick();

      // ==============================================================

      // ==============================================================
      if (current_time - last_ctrl_time >= 20) {
          last_ctrl_time = current_time;

          Control_Task_20ms();
      }

      // ==============================================================

      // ==============================================================
      if (current_time - last_upload_time >= 20) {
          last_upload_time = current_time;

          tx_buffer[0] = 0xAA;
          tx_buffer[1] = 0x66;

          tx_buffer[2] = (motors[0].enc_delta >> 8) & 0xFF;
          tx_buffer[3] = motors[0].enc_delta & 0xFF;
          tx_buffer[4] = (motors[1].enc_delta >> 8) & 0xFF;
          tx_buffer[5] = motors[1].enc_delta & 0xFF;
          tx_buffer[6] = (motors[2].enc_delta >> 8) & 0xFF;
          tx_buffer[7] = motors[2].enc_delta & 0xFF;
          tx_buffer[8] = (motors[3].enc_delta >> 8) & 0xFF;
          tx_buffer[9] = motors[3].enc_delta & 0xFF;

          uint8_t sum = 0;
          for (int i = 2; i <= 9; i++) sum += tx_buffer[i];

          tx_buffer[10] = sum;
          tx_buffer[11] = 0x0D;

          HAL_UART_Transmit(&huart1, tx_buffer, 12, 10);
      }

      // ==============================================================

      // ==============================================================
      if (huart1.RxState != HAL_UART_STATE_BUSY_RX) {
          __HAL_UART_CLEAR_OREFLAG(&huart1);
          __HAL_UART_CLEAR_NEFLAG(&huart1);
          __HAL_UART_CLEAR_FEFLAG(&huart1);
          huart1.RxState = HAL_UART_STATE_READY;
          huart1.Lock = HAL_UNLOCKED;
          HAL_UART_Receive_IT(&huart1, &rx_byte, 1);
      }
    /* USER CODE END WHILE */

    /* USER CODE BEGIN 3 */
  }
  /* USER CODE END 3 */
}

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
/* USER CODE BEGIN 4 */
// ==============================================================

// ==============================================================
void HAL_UART_RxCpltCallback(UART_HandleTypeDef *huart) {
    if(huart->Instance == USART1) {

        // 新数据从尾部推入
        rx_buffer[9] = rx_byte;


        if(rx_buffer[0] == 0xAA && rx_buffer[1] == 0x55 && rx_buffer[9] == 0x0D) {
            uint8_t sum = 0;
            for(int i = 2; i <= 7; i++) sum += rx_buffer[i];

            if(sum == rx_buffer[8]) {
                target_vx = (int16_t)((rx_buffer[2] << 8) | rx_buffer[3]);
                target_vy = (int16_t)((rx_buffer[4] << 8) | rx_buffer[5]);
                target_w  = (int16_t)((rx_buffer[6] << 8) | rx_buffer[7]);

                last_cmd_time = HAL_GetTick();

                // 清空缓冲区，防止同一有效包被重复识别
                for(int i = 0; i < 10; i++) {
                    rx_buffer[i] = 0;
                }
            } else {
                // 校验失败，整体前移一格丢弃脏数据
                for(int i = 0; i < 9; i++) rx_buffer[i] = rx_buffer[i+1];
            }
        } else {

            for(int i = 0; i < 9; i++) rx_buffer[i] = rx_buffer[i+1];
        }

        HAL_UART_Receive_IT(&huart1, &rx_byte, 1);
    }
}

// 错误中断兜底回调
void HAL_UART_ErrorCallback(UART_HandleTypeDef *huart) {
    if(huart->Instance == USART1) {
        __HAL_UART_CLEAR_OREFLAG(huart);
        __HAL_UART_CLEAR_NEFLAG(huart);
        __HAL_UART_CLEAR_FEFLAG(huart);
        __HAL_UART_CLEAR_PEFLAG(huart);

        HAL_UART_AbortReceive_IT(huart);
        HAL_UART_Receive_IT(&huart1, &rx_byte, 1);
    }
}
/* USER CODE END 4 */
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
